Natchpai/AeroOptix-Horizon/assets/AO-Horizon-title-v2.png

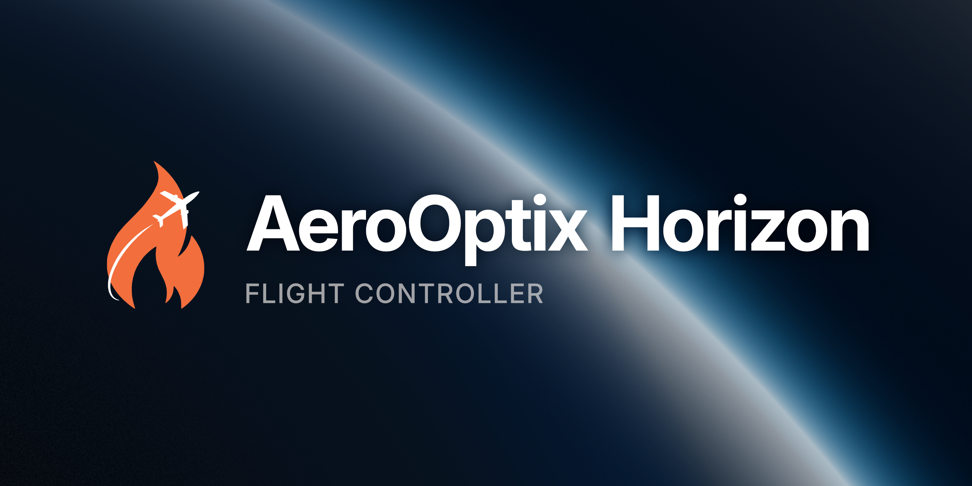
assets/AO-Horizon-title-v2.png
