Natchpai/AeroOptix-Horizon/hardware/AO-Horizon/documents/design/README.md

# Design Documents

The specification is the requirements source of truth. The other records point to its IDs instead of repeating them.

| File | Content |
| ---- | --- |
| `AO-HORIZON_SPEC_EN.md` | Hardware requirements, decisions (DEC-xxx) and open items (OPEN-xxx). |
| `AO-HORIZON_EXECUTION_CHECKLIST_EN.md` | P0 to P4 work plan and evidence tracker. |
| `AO-HORIZON_IMU_SELECTION_EN.md` | ICM-45686 selection, key data and sourcing (DEC-008, DEC-009). |
| `AO-HORIZON_BARO_MAG_SELECTION_EN.md` | ICP-20100, BMP581 (BMP384 fallback) and IST8310 selection (BMM150 replaced, BMP390 removed): key data and sourcing (DEC-010, DEC-011, OPEN-019). |
| `AO-HORIZON_POWER_BUDGET_EN.md` | Draft rail loads, tolerances, brownout and protection needs (P0-017). |
| `AO-HORIZON_PIN_ALLOCATION_EN.md` | Draft STM32H743 and STM32F100 pin allocation (P1). |
| `AO-HORIZON_H7_MCU_SOURCING_EN.md` | STM32H743VI price and stock snapshot. |
| `AO-HORIZON_PINMAP_REVIEW_EN.md` | H743 and IO MCU pinmap review 0.3, answered by the software team on 2026-10-24 (0.2 answers kept). Applied in spec rev 0.12, with the IO MCU changed to the F100. Not approved. |
| `AO-HORIZON_PINMAP_DECISIONS_EN.md` | Spec changes, team decisions and software answers after pinmap review 0.2. Answered 2026-10-24; applied in spec rev 0.11, S7 update in 0.12. |
| `AO-HORIZON_INTEGRATION_QUESTIONS_EN.md` | Integration questions rev 0.4: open questions only (P0-022): ESC (D13), parts and team tests. Earlier answers are in spec rev 0.13 and 0.14 and in Git history. |
| `AO-HORIZON_POWER_MUX_NOTES_EN.md` | TPS2121 power mux: the four modes and how to calculate the PR1, CP2, OV, ILIM and SS parts, with the values as drawn (DEC-029 to DEC-034). Design note, not a record. |
| `what-next.md` | Personal reminder list of next steps. Points to spec and checklist IDs; not a record. |
