Natchpai/AeroOptix-Horizon/hardware/AO-Horizon/documents/design/AO-HORIZON_POWER_BUDGET_EN.md

# AeroOptix-Horizon: Power Budget

**Revision:** 0.15
**Updated:** 2026-11-03
**Status:** Draft record with open `TBD` rows. The main 3.3 V buck is TPS62142RGTR (DEC-012), the 5 V input is a TPS2121 power mux with a 1.5 A limit (DEC-029, DEC-030) and the `+3V3A` LDO is TPS73533DRBR (DEC-027). No other rail, regulator or protection part is approved. Not a verification record.
**Requirement refs:** PWR-010 to PWR-014, SAF-012 to SAF-014, OPEN-006, OPEN-007, OPEN-011, OPEN-012 (closed), OPEN-021, OPEN-024 (closed), OPEN-025 (spec rev 0.24). Decisions: DEC-010, DEC-012, DEC-016, DEC-018, DEC-019, DEC-025, DEC-026 (superseded), DEC-027, DEC-028, DEC-029, DEC-030, DEC-031, DEC-032, DEC-033, DEC-034. Checklist task: P0-017.
**Decision owner:** Hardware

Single record for rail loads, rail tolerances, brownout thresholds and power protection requirements.

Evidence labels follow `.claude/rules/engineering.md`: `VERIFIED`, `ASSUMED`, `ESTIMATED`, `NOT_VERIFIED`. No datasheet PDF was opened by Claude; TI values come from NotebookLM source fulltext.

Source keys used below:
- **Spec**: `AO-HORIZON_SPEC_EN.md`.
- **Bosch**: Bosch Sensortec product page, fetched 2026-10-18.
- **IMU rec**: `AO-HORIZON_IMU_SELECTION_EN.md` (datasheet values extracted by agy, `NOT_VERIFIED`).
- **Snippet**: search-result text of a PDF datasheet. Not opened, always `NOT_VERIFIED`.
- **TI**: ti.com product pages and HTML datasheets (TPS62142: SLVSAJ0F Rev. F; TPS735: SBVS087M), fetched 2026-10-18 and 2026-10-19.
- **TI eFuse**: TPS2592x datasheet SLVSCQ3B (June 2016), NotebookLM notebook `TPS25925x eFuse` (added by the human owner, 2026-10-31), read as source fulltext. The eFuse was removed on 2026-11-01 (DEC-029).
- **TI mux**: TPS212x datasheet SLVSEA3F (August 2020), NotebookLM notebook `TPS212x 2.8-V to 22-V Priority Power MUX with Seamless Switchover` (added by the human owner), read as source fulltext.

Fetches to st.com, invensense.tdk.com, te.com and en.benewake.com failed on 2026-10-18 (`getaddrinfo EAI_AGAIN`). The rows that depend on them are `TBD`.

## 1. Fixed limits

| Item | Value | Source | Label |
| ---- | ----- | --- | ----- |
| Board input (PWR-010) | 4.5 / 5 / 5.5 V min/nom/max, ±10 %, source capacity 2 A | Spec, DEC-007 | `VERIFIED` (requirement) |
| Servo supply (PWR-011) | 6 V nominal, min/max TBD; 10 A continuous, 15 A instantaneous (UBEC-10A reference, not an approved part). On the board: the UBEC (10 A, XT30, model TBD) plugs into a board-mount XT30 and the 8 headers share a 6 V bus (DEC-019) | Spec, DEC-007, DEC-019 | `VERIFIED` (requirement) |

## 2. Candidate power tree

From the spec diagram. Candidate only, not approved (spec PWR-013).

```text
6S battery -> XT90-S -> PM02D -> CRIUS PDB v1.0
                           |            |
                           |            +-> 6 V UBEC -> board XT30 -> on-board 6 V bus
                           |                             -> 8 servo headers (+ IF-050 sense)
                           +-> TPS2121 mux IN1, 1.5 A (DEC-029/030) -> 5 V bus -> 3.3 V (MCUs, baro, mag)
                                                                  +-> +3V3A LDO -> 3.3 V_IMU (2 × IMU only, DEC-025)
                                                                  +-> 5 V external connectors
USB VBUS (bench) -> TPS2121 mux IN2 ----------------------------^
```

- `ASSUMED`: the 5 V input feeds the external connectors directly, and both 3.3 V rails come from the 5 V input.
- 3.3 V_IMU is the `+3V3A` rail from its own LDO, and it feeds only the 2 IMUs, on VDD and VDDIO (DEC-025, human owner, 2026-10-26). The LDO is TPS73533DRBR (DEC-027, 2026-10-31).
- USB VBUS powers the board and all external 5 V ports on the bench without the battery (team; all ports: human owner, 2026-10-24). Since 2026-11-01 the TPS2121 power mux joins USB (IN2) and the PM02D (IN1) and blocks reverse current on both channels (TI mux 9.3.6, `VERIFIED`). PR1 has a 12.1 kΩ / 5 kΩ divider from the PM02D and CP2 a 16.5 kΩ / 5 kΩ divider from `VBUS` (DEC-031 to DEC-034), so the PM02D has priority; USB takes over below about 3.98 V typ at `VBUS` 5.0 V (XCOMP) or 3.56 V typ (VREF mode, 16.5 kΩ not fitted).
- The saved `power_supplies.kicad_sch` draws `+3V3` from the TPS62142RGTR buck (DEC-012) and `+3V3A` from the TPS73533DRBR LDO (DEC-027), both fed from `+5V`; the buck through a 0.33 µH inductor (`+5V_BUCK`). The TPS2121 power mux (U101) is wired from `PM02_5V` (IN1) and `VBUS` (IN2) to `+5V`, with ILIM 80.6 kΩ, a PR1 priority divider 12.1 kΩ / 5 kΩ, a CP2 divider 16.5 kΩ (fitted) / 5 kΩ from `VBUS`, OV dividers 23.7 kΩ / 5 kΩ on both inputs and SS 10 nF; checked against TI mux on 2026-11-01 (sections 6 and 7). The human owner declared the sheet complete on 2026-10-31 and changed the 5 V input to the power mux on 2026-11-01. Since 2026-11-03 a status LED on the mux ST pin is drawn again: Q101 switches D103 from `+5V` (OPEN-025, drawn, not decided; its current is `TBD` until the resistor values are set). Details: spec 4.3 "Schematic state".

## 3. Load table

Typical or average current per load. Peak current listed where known. "TBD" means no source yet.

### 3.3 V_IMU

| Load | Qty | Current each | Peak | Source | Label |
| ---- | --- | --- | ---- | --- | ----- |
| ICM-45686, 6-axis low-noise, 6400 Hz | 2 | 0.44 mA | TBD | IMU rec (DS Table 3) | `NOT_VERIFIED` |

### 3.3 V

| Load | Qty | Current each | Peak | Source | Label |
| ---- | --- | --- | ---- | --- | ----- |
| STM32H743VIT6 | 1 | TBD | TBD | Not read yet (NotebookLM notebook `STM32H743VI`) | `NOT_VERIFIED` |
| STM32F100C8T6B | 1 | 15.4 mA max at 24 MHz, all peripherals on, code from Flash, TA 85 °C | Not stated | F1 value-line DS Table 12 (NotebookLM) | `VERIFIED` for the table condition (8 MHz external clock with PLL); at a 24 MHz HSE without PLL `ESTIMATED` as no higher |
| ICP-20100 | 1 | TBD | TBD | invensense.tdk.com unreachable | `NOT_VERIFIED` |
| BMP581 (barometer 2, DEC-010) | 1 | TBD | TBD | Not read yet (NotebookLM notebook `BMP581`) | `NOT_VERIFIED` |
| IST8310 (magnetometer, DEC-011) | 1 | 1.2 mA at 200 sps, 0.32 mA at 50 sps (typ, AVDD 2.8 V) | Not stated | IST8310 DS V1.2, 4.3 (NotebookLM) | `VERIFIED` at 2.8 V; at 3.3 V `NOT_VERIFIED` |
| I2C pull-ups | TBD | TBD | - | Depends on P1-004, P1-005 | `TBD` |
| LEDs: 3 board (IF-047), 3 px4io, safety LED (IF-049) | 7 | TBD (set by the resistors) | - | Resistors not chosen | `TBD` |
| External 3.3 V devices | TBD | TBD | TBD | Not defined | `TBD` |

### 5 V (external connectors and regulator input)

| Load | Ref | Current each | Peak | Source | Label |
| ---- | --- | --- | ---- | --- | ----- |
| Telemetry 1, ELRS receiver | IF-010 | TBD (5 V supply; model TBD, team) | TBD | Team | `TBD` |
| Telemetry 2 | IF-011 | TBD (no device planned; connector fitted for a second receiver) | TBD | Team | `TBD` |
| GPS1 + compass | IF-012 | TBD (Holybro M9N, to be confirmed) | TBD | Team | `TBD` |
| MS4525DO | IF-014 | TBD (5 V Pixhawk layout if the module has a regulator; 3.3 V or 5 V version TBD, team) | TBD | Snippet | `NOT_VERIFIED` |
| TF-Luna | IF-015 | 70 mA or less average (3.7 to 5.2 V supply) | 150 mA | Snippet (third-party PDF) | `NOT_VERIFIED` |
| 3.3 V regulator input | - | Sum of section 3.3 V loads | TBD | - | `TBD` |

### 6 V servo rail (on the board, DEC-019)

All of this current passes through the XT30 input and the on-board 6 V and servo GND bus (OPEN-021). Every servo model is rated for 6 V (human owner). Each servo header pin carries only its own servo's current.

| Load | Ref | Qty | Current each | Stall / peak | Label |
| ---- | --- | --- | --- | --- | ----- |
| Tilt servos, RDS3235 (team design) | IF-034 to IF-037 | 4 | TBD; team bench target: all 4 at or below 10 A while tilting 0 to 90° at hover thrust | TBD (team bench test) | `TBD` |
| Flaperon and ruddervator servos, Kingmax C507 and DS-843MG (positions TBD, team) | IF-030 to IF-033 | 4 | TBD | TBD (team bench test) | `TBD` |
| Spare outputs on the H743 | IF-017 to IF-019 | 0 planned (DEC-018); pads only | - | - | - |

All 8 servos can move at the same time (team): the tilt servos move all the time in hover, and the 4 surface servos move together in cruise.

The 4 motor outputs (IF-040 to IF-043) carry only the signal to 4 separate Skywalker 80A V2 ESCs; motor power does not pass through the board (`ASSUMED`). The ESC headers have the + pin removed, so the ESC BECs (5 V) do not reach the board.

## 4. Totals

| Rail | Known subtotal | Missing | Budget | Margin | Label |
| ---- | --- | --- | --- | --- | ----- |
| 3.3 V_IMU | 0.88 mA (2 × 0.44 mA) | IMU peak | TBD. 500 mA, TPS73533DRBR (DEC-027, TI SBVS087M 5.3). | TBD | `ESTIMATED` from `NOT_VERIFIED` inputs |
| 3.3 V | about 17 mA (IST8310 at 200 sps, F100 max 15.4 mA) | H743, ICP-20100, BMP581, pull-ups, LEDs | 2 A, TPS62142RGTR (DEC-012, TI SLVSAJ0F) | TBD | `ESTIMATED` from partial inputs |
| 5 V | 70 mA average, 150 mA peak (TF-Luna only) | All other external loads, 3.3 V regulator input | 2 A source (PWR-010); power mux limit 1.0 / 1.5 / 2.0 A with 80.6 kΩ (DEC-030, TI mux, `VERIFIED`) | TBD | `ESTIMATED` from partial inputs |
| 6 V (on the board) | none | All servo loads | 10 A cont., 15 A inst. (PWR-011), UBEC and XT30 input | TBD | `TBD` |

The subtotals are far from complete. Do not use them to size a regulator. The MCUs and the external 5 V devices are likely the largest loads (`ASSUMED`).

## 5. Rail tolerances (PWR-013)

| Rail | Nominal | Min | Max | Load step | Ripple / noise | Label |
| ---- | --- | --- | --- | --- | --- | ----- |
| 5 V input | 5 V | 4.5 V | 5.5 V | TBD | TBD | `VERIFIED` (PWR-010) for min/max |
| 3.3 V | 3.3 V | TBD | TBD, at most 3.6 V | TBD | TBD | `TBD` |
| 3.3 V_IMU | 3.3 V | TBD | TBD, at most 3.6 V | TBD | TBD | `TBD` |
| 6 V servo | 6 V | TBD | TBD | TBD | TBD | `TBD` |

Known upper bounds for the 3.3 V rails:
- ICM-45686 VDD and VDDIO max 3.6 V recommended, 4 V absolute maximum (IMU rec, `NOT_VERIFIED`).
- IST8310 AVDD and DVDD max 3.6 V recommended and 3.6 V absolute maximum (IST8310 DS V1.2, 4.1 and 4.2, `VERIFIED` via NotebookLM). This is the tightest limit on the 3.3 V rail.
- `ESTIMATED`: 3.3 V nominal leaves 0.3 V (9 %) to the 3.6 V limit for regulator tolerance, load transients and overshoot.
- F100 VDD 2 to 3.6 V (F1 value-line DS Table 8, `VERIFIED`). H743 VDD range `TBD`.

## 6. Brownout and reset thresholds (PWR-014)

| Item | Threshold | Source | Label |
| ---- | --- | --- | ----- |
| H743 BOR level (option bytes) | TBD | ST datasheet / RM | `NOT_VERIFIED` |
| H743 PVD level | TBD | ST datasheet / RM | `NOT_VERIFIED` |
| F100 POR/PDR | Falling 1.8 / 1.88 / 1.96 V, rising 1.84 / 1.92 / 2.0 V (min / typ / max), 40 mV hysteresis | F1 value-line DS Table 10 (NotebookLM) | `VERIFIED` |
| F100 PVD level | 8 levels, falling-edge typ 2.08 to 2.78 V, 100 mV hysteresis; enabled by software | F1 value-line DS Table 10 (NotebookLM) | `VERIFIED` |
| 5 V input undervoltage detect | TBD (does the board monitor 5 V?) | Not defined | `TBD` |
| 5 V power mux input UV (U101) | Rising 2.5 / 2.65 / 2.8 V, falling 2.4 / 2.55 / 2.7 V. The 4.3 V eFuse UVLO is gone with the eFuse (DEC-029) | TI mux, Electrical Characteristics | `VERIFIED` |
| 5 V source priority (U101 PR1, CP2; DEC-031 to DEC-034) | XCOMP (R105 fitted, as saved, DEC-033): to USB at 3.78 / 3.98 / 4.18 V for `VBUS` 4.75 / 5.0 / 5.25 V; worst case 4.44 V at `VBUS` 5.25 V with 1 % resistors and the 40 mV comparator offset, below the 4.5 V minimum (DEC-034). VREF mode (R105 removed): to USB at 3.39 / 3.56 / 3.73 V, back at 3.45 / 3.63 / 3.76 V. PR1 12.1 kΩ / 5 kΩ, CP2 16.5 kΩ / 5 kΩ | TI mux equations 5 and 12 form, VREF (spec 4.7) | `ESTIMATED` |
| 5 V input overvoltage (U101 OV1, OV2) | 6.08 V typ, 5.80 to 6.31 V over the VREF range before resistor tolerance; the channel turns off | TI mux 10.2.4.2, equation 6 (spec 4.7) | `VERIFIED` (typ), `ESTIMATED` (range) |
| 3.3 V buck soft-start (U102) | 10 nF SS/TR (DEC-028): about 5 ms | TI SLVSAJ0F equation 10 (spec 4.7) | `ESTIMATED` |
| 3.3 V buck PG (U102) | Open drain, pulled up by R110 100 kΩ to `+3V3`, local label `3V3_PG`, hierarchical label `3V3_DONE` (sheet pin on `top_hierarchical`, not wired further) | Saved schematic, 2026-11-01 | `VERIFIED` (as drawn) |
| 6 V servo rail monitor | Read by the F100 through the 3:1 divider (IF-050); threshold TBD | px4io-v2 | `TBD` |

## 7. Protection requirements (OPEN-006, OPEN-007, SAF-012 to SAF-014)

All `TBD`. Items to decide:

- [x] 5 V power mux values (P2-020, checked 2026-11-01), TI mux, `VERIFIED` unless marked: TPS2121, 80.6 kΩ ILIM gives 1.0 / 1.5 / 2.0 A (DEC-030); OV trip 6.08 V typ on both inputs; IN and OUT 24 V absolute maximum; input UV 2.65 V typ; 10 nF SS gives about 0.65 ms ramp and about 0.47 A inrush into about 60 µF (`ESTIMATED`, outside TI Table 9-1); fast-trip at about 2.4 × ILM, then off for about 25 ms; thermal shutdown auto-recovers. PM02D priority with a 12.1 kΩ / 5 kΩ PR1 divider (DEC-031, DEC-034) and the XCOMP fast switchover with a 16.5 kΩ / 5 kΩ CP2 divider from `VBUS` (DEC-032), R105 fitted (DEC-033).
- [x] Removed 2026-11-01 (DEC-029). 5 V input eFuse values (P2-017, closed 2026-10-31), TI eFuse, `VERIFIED` unless marked: TPS259251DRC, 45.3 kΩ ILIM gives 1.75 / 2.1 / 2.45 A; overvoltage clamp 6.1 V typ (5.5 to 6.75 V); VIN 20 V absolute maximum; turn-on at the internal UVLO (4.3 V typ); 1 nF dV/dT gives about 5 ms ramp and about 56 mA inrush into about 60 µF (`ESTIMATED`); thermal fault auto-retry after 110 ms.
- [ ] 5 V input, still open: reverse polarity; D101 SZSMF5.0A TVS rating against the PM02D input (datasheet not checked); input capacitance for the PM02D cable (TI mux section 11 suggests a large capacitance near the input for long cables; IN1 has 2 × 100 nF).
- [x] USB VBUS and PM02D 5 V OR-ing: TPS2121 power mux (DEC-029), reverse current blocking on both channels (TI mux 9.3.6, `VERIFIED`). Source priority: PM02D first, XCOMP switchover (DEC-031 to DEC-034).
- [ ] 6 V servo bus on the board (DEC-019): board-mount XT30 input, rating against 10 A continuous and 15 A peak `NOT_VERIFIED`; 6 V and servo GND copper; servo GND joined to logic GND at one point away from the sensors; no back-feed from the 6 V bus into the 5 V side (OPEN-021).
- [ ] 6 V servo rail: overcurrent behavior, pulse duration of the 15 A rating, bulk capacitance.
- [ ] USB-only power: VBUS current limit. USB feeds all external 5 V ports (human owner, 2026-10-24) (OPEN-006).
- [ ] External 5 V connectors: short-circuit protection per connector or per group.
- [ ] ESD on external connectors and USB (SAF-014).
- [ ] Safe output state on 5 V loss or 6 V fault (SAF-012, SAF-013).

## 8. Findings

| Severity | Ref | Label | Finding | Source |
| --- | --- | ----- | --- | --- |
| MAJOR | PWR-012 | `NOT_VERIFIED` | Board current budget cannot be closed: MCU currents and all external 5 V device models are missing. | Section 4 |
| MAJOR | IF-030 to IF-037 / UBEC | `NOT_VERIFIED` | All 8 servos can move at once and stall current is not known. The 10 A team target covers only the 4 tilt servos (OPEN-007). | Section 3 |
| MAJOR | XT30 input / 6 V bus | `NOT_VERIFIED` | The XT30 input carries the total servo current, up to 10 A continuous and 15 A peak. Its rating is not checked. A header position (about 3 A per pin, `ESTIMATED`) was replaced by the XT30 on 2026-10-24 (OPEN-021). | DEC-019, PWR-011 |
| INFO | U101 PR1 / `+5V` | `ESTIMATED` | Closed 2026-11-01: the drawn VCOMP mode let USB carry the board when both sources were present. PR1 now has a divider from IN1 (DEC-031, 12.1 kΩ / 5 kΩ since DEC-034), so the PM02D has priority down to about 3.98 V typ in XCOMP or 3.56 V typ in the VREF mode. | TI mux Table 9-3; spec 4.7 |
| MINOR | DEC-030 / 5 V | `VERIFIED` | The power mux limit with 80.6 kΩ is 1.0 to 2.0 A (1.5 A typ). The board plus all external 5 V loads must fit under 1.0 A for a worst-case part, with the load currents still unknown. | Section 4; TI mux |
| MINOR | U101 / `+5V` | `ESTIMATED` | With CP2 at `GND` there is no fast switchover: up to 100 µs, so `+5V` may dip about 1.7 V at 1 A into about 60 µF when the active source drops with the other present. | Spec 4.7; TI mux 9.3.7 |
| MINOR | IST8310 / 3.3 V | `VERIFIED` | IST8310 absolute maximum supply is 3.6 V, so the 3.3 V rail must never overshoot by more than 0.3 V (9 %), including start-up and load steps. | IST8310 DS V1.2, 4.1 |
| INFO | IF-022 / 5 V | `VERIFIED` (team answer) | USB VBUS powers the board on the bench. It joins the PM02D 5 V through the power mux IN2 (DEC-029). | Section 2 |
| MINOR | IF-022 / 5 V | `ESTIMATED` | USB feeds all external 5 V ports (human owner). GPS, ELRS, TF-Luna (150 mA peak alone) and airspeed together with the board may exceed a 500 mA USB port. | Section 3 |

## 9. Open inputs

- [ ] ELRS receiver model and supply current (team, P0-022). GPS: Holybro M9N supply current. Telemetry 2: no device planned.
- [ ] Servo stall current (team bench test, P0-022). Servo power passes through the board (DEC-019), so it also sizes the board input and bus.
- [x] 3.3 V_IMU rail structure: `+3V3A` from its own LDO, IMUs only (DEC-025, 2026-10-26). LDO TPS73533DRBR (DEC-027, 2026-10-31).
- [x] USB VBUS as a board power source: yes, on the bench (team). It feeds all external 5 V ports (human owner, 2026-10-24).
- [x] TPS259251DRC values from TI: done 2026-10-31 (section 7, notebook `TPS25925x eFuse`). Part removed 2026-11-01.
- [x] TPS2121 values from TI: done 2026-11-01 (section 7, TI mux).
- [x] Power mux priority: PM02D first, PR1 divider, drawn (DEC-031, 2026-11-01).
- [x] Fast switchover: XCOMP with a 16.5 kΩ / 5 kΩ CP2 divider from `VBUS`, PR1 12.4 kΩ / 5 kΩ, drawn (DEC-032, 2026-11-01); R101 later 12.1 kΩ (DEC-034).
- [x] R105 default population: fitted, XCOMP is the default (DEC-033, 2026-11-01).
- [x] XCOMP switch-point tolerance: R101 12.1 kΩ gives 4.44 V worst case with 1 % resistors, below the 4.5 V minimum (DEC-034, 2026-11-02; OPEN-024 closed).
- [ ] XT30 current rating (OPEN-021).
- [ ] STM32H743 VDD range, run current at the planned clock, BOR/PVD levels (user-supplied values or approved datasheet route). STM32F100: done (VDD 2 to 3.6 V, Table 8; sections 3.3 V and 6).
- [ ] ICP-20100 supply range and current.
- [ ] MS4525DO version (3.3 V or 5 V) and supply current (team, P0-022). The team accepts the 5 V Pixhawk layout if the module has its own regulator.
- [ ] Retry the official pages for TF-Luna and MS4525DO.

## 10. Sources

- IST8310 Datasheet, Version 1.2 (NotebookLM notebook `IST8301`, not opened by Claude)
- F1 value-line DS: ST DocID16455 Rev 9 (STM32F100x4/6/8/B), NotebookLM notebook `STM32F100`, read as source fulltext
- TF-Luna snippet source (third-party PDF, not opened): https://files.waveshare.com/upload/c/c3/SJ-GU-TF-Luna_A05_Datasheet.pdf
- TI TPS62142: https://www.ti.com/product/TPS62142
- TI TPS735 (TPS73533DRBR): https://www.ti.com/product/TPS735 and https://www.ti.com/document-viewer/TPS735/datasheet/electrical-characteristics-slvscd4719
- TI TPS212x (TPS2121): SLVSEA3F, https://www.ti.com/product/TPS2121 (ACTIVE, fetched 2026-11-01), in NotebookLM notebook `TPS212x 2.8-V to 22-V Priority Power MUX with Seamless Switchover` (added by the human owner; not opened by Claude)
- TI TPS2592x (TPS259251DRC, removed): SLVSCQ3B, https://www.ti.com/lit/ds/symlink/tps25925.pdf, in NotebookLM notebook `TPS25925x eFuse` (added by the human owner, 2026-10-31; not opened by Claude)
- ICM-45686: see `AO-HORIZON_IMU_SELECTION_EN.md`
- Requirements: `AO-HORIZON_SPEC_EN.md` sections on power, safety and interfaces
