Natchpai/AeroOptix-Horizon/hardware/AO-Horizon/documents/manufacturing/README.md

# Manufacturing Documents

This directory groups manufacturing-related documents and outputs.

- `Assembly/` — Assembly information and bill of materials.
- `Fabrication/` — Fabrication outputs such as Gerber files.
