Natchpai/AeroOptix-Horizon/hardware/AO-Horizon/documents/manufacturing/Assembly/README.md

# Assembly Documents

This directory contains assembly documentation for the project.

- `BOM/` — Bill of materials and related assembly records.
