Natchpai/AeroOptix-Horizon/hardware/AO-Horizon/documents/manufacturing/Fabrication/README.md

# Fabrication Documents

This directory contains fabrication outputs for PCB manufacturing.

- `Gerbers/` — Gerber and related fabrication files.
