Natchpai/AeroOptix-Horizon/CHANGELOG.md

# Changelog

Notable changes to this hardware project are documented here.

## [Unreleased]

### Added

- KiCad 10 project scaffold under `hardware/AO-Horizon/`: root schematic, `top_hierarchical`, `block_diagram`, `power_supplies` and `revision_history` sheets, and an empty PCB file. No schematic symbols or PCB footprints are placed yet.
- Draft advanced specification, handoff and execution checklist (`documents/design/`), rev 0.1, marked "NOT FOR FABRICATION". Defines the STM32H743VIT6 + STM32F103C8T6 dual-MCU architecture and lists open items OPEN-001 to OPEN-010.
- Custom KiCad worksheet templates, theme, and fabrication, assembly and impedance note templates (`templates/`).
- STEP 3D model for LQFP-100 14×14 mm, 0.5 mm pitch (`library/3D/`).
- Documentation folder structure with README stubs for manufacturing, schematic, verification and images.
- Project README, CERN-OHL-W-2.0 licence, and a pull request template.
- Claude Code project configuration (rules, skills, KiCad file-protection hook, permissions).
- `.gitattributes` marking development-only files (`.claude/`, `CLAUDE.md`, `README.md`, `.github/`, `.gitignore`, `.gitattributes`, `.vscode/`) as `export-ignore`.
- `CLAUDE.md` with repository layout, read-only design rules and git approval rules.
- `CHANGELOG.md`.
- Design records in `documents/design/`: IMU selection (ICM-45686), barometer and magnetometer selection (ICP-20100, BMP390, BMM150), draft power budget, draft STM32H743 and STM32F103 pin allocation, and STM32H743VI price and stock.
- Power sheet parts in `power_supplies.kicad_sch`: JST GH power module connector (`+VIN`, `PM02_SCL`, `PM02_SDA`), TPS62142RGTR 3.3 V buck with 2.2 µH inductor, TPS73533DRBR `+3V3A` LDO (drawn, not decided), 3.3 V indicator LED, and a DNP DF2S6.2CT on `+VIN`. All parts are unannotated, and `+5V` has no source yet (OPEN-012).
- Project library under `library/` with `sym-lib-table` and `fp-lib-table`: STM32 MCU, regulator, ESD, diode, connector, FET and passive parts with footprints and 3D models.
- Library starting points for the sensors: ICM-45686, ICP-20100, BMP390 and BMM150 symbols with LGA and WLCSP footprints. Not placed. Pin maps match the datasheet tables; land patterns and pin 1 orientation are not checked yet (OPEN-013). The BMM150 3D model is missing from the KiCad 10 install.
- BMP581 library starting point: `0_Sensor_Pressure:BMP581`, pin map checked against BST-BMP581-DS004-13 Rev 1.13 Table 28 through NotebookLM. Not placed. BMP581 is a candidate, not a decided part (OPEN-014).
- TPS16412DRC eFuse symbol and `Texas_VSON-10-1EP_3x3mm_P0.5mm_EP1.65x2.4mm_ThermalVias` footprint in the project library.
- TPS16412DRC eFuse placed on `power_supplies.kicad_sch` (unannotated). ERC not run.
- IST8310 library part: stock KiCad `0_Sensor_Magnetic:IST8310` symbol and `0_Package_LGA:LGA-16_3x3mm_P0.5mm` footprint, with MFR, MPN and LCSC C2683055 fields. Not placed. The IST8310 datasheet (V1.2 and V1.8) has no land pattern, so the footprint fit is `ESTIMATED` from the package drawing.
- Pinmap review sheet for the software team (`AO-HORIZON_PINMAP_REVIEW_EN.md`). Rev 0.2 adds proposed pins for the remaining functions and questions Q11 to Q19. No answers received yet.
- Pin allocation rev 0.3: draft pins for LEDs, buzzer, safety switch, IST8310 DRDY and RSTN, IMU pin 9 and F103 NRST/BOOT0 control (`ASSUMED`, not approved), and findings F-08 to F-10 (PA10 note, PM02D I2C bus not assigned, TIM15 DMA).
- PX4 Matek H743-Slim board port files as a pin-map reference in `documents/reference/px4-matek-h743-slim/`: unmodified copies from PX4-Autopilot `b26146e` and PX4/NuttX `8626377`. Not design data.
- `documents/design/what-next.md`: personal reminder list of next steps.
- Pinmap decisions file for the team (`AO-HORIZON_PINMAP_DECISIONS_EN.md`): spec rows that the team's pinmap answers change, decisions D1 to D7, software questions S1 to S7 and proposals H1 and H2, checked against PX4 v1.16.2 board files.
- Integration questions for the team (`AO-HORIZON_INTEGRATION_QUESTIONS_EN.md`, rev 0.1): servo power path (D8), mounting and cable entry (D9), environment (D10), safety switch and GPS module (D11), external devices and connectors, and software questions S8 to S10. The proposed Pixhawk-style JST-GH pinouts are `NOT_VERIFIED`. Tracked as P0-021 and spec REF-09.
- Team website in `web/` (Vite, React, shadcn-admin template): block diagram (system and board views), MCU pinouts, and an Overview with phase, gate progress, open items and recent spec changes. It reads the spec, checklist, pin allocation and root README at build time and adds no values of its own. Deployed to GitHub Pages by `.github/workflows/pages.yml` on merges to `main` (PRs #18 to #24).
- Power view on the team website: power from source to load, left to right, with grouped loads. Feeds the records do not give are drawn as candidates. Built from the spec IDs, like the other views; no new design values.
- DEC-025 (specification rev 0.16, human owner): `+3V3A` feeds only the 2 ICM-45686 IMUs, on VDD and VDDIO. OPEN-011 now covers the LDO part, the load, and the IMU SPI level match with the H743 on `+3V3` and power-up order. Checklist rev 0.15, power budget rev 0.8, IMU selection rev 0.9, root `README.md` and `what-next.md` updated to match. No KiCad file read or changed.
- README title image (`assets/AO-Horizon-v2.png`) and the AeroOptix black-and-white logo (`documents/images/Logos/`); the two old nP logo files were replaced by `np_black.png`.
- Library parts (`82f5669`): TPS25923x to TPS25926x eFuse symbols for the VSON-10 DRC package, the JIERR PCR0420 inductor footprint and 3D model, and the STM32F100C8Tx symbol (renamed from STM32F103C8Tx). Uncommitted: the TPS25925x and TPS25926x symbols now go in the BOM and on the board, and a new `L_0603_1608Metric` inductor footprint.
- DEC-026 (specification rev 0.18, human owner): TPS259251DRC eFuse between the PM02D `+VIN` and `+5V`, current-limit target 2 A. Replaces the TPS16412DRC and 1.5 A of DEC-024.
- DEC-027 (specification rev 0.19, human owner): TPS73533DRBR as the `+3V3A` LDO, with CMP-009. DEC-028: C111 SS/TR 10 nF for about 5 ms soft-start; its part number fields still name 3.3 nF (P2-019). Passive MFR and MFR.P/N are left for the human owner to choose later.
- TPS259251DRC data from TI SLVSCQ3B, read through NotebookLM (the human owner's notebook `TPS25925x eFuse`; Claude's duplicate `TPS2592x eFuse` holds the same revision). Recorded in spec CMP-008 and 4.7.
- Root sheet `AO-Horizon.kicad_sch`: a "DESIGN CONVENTIONS" text note (net names, style, reference letters, units, part fields) replaces the general-note placeholders (uncommitted).
- PCB: one 27 × 29 mm rectangle on `Edge.Cuts`, and title fields `PROJECT_ID` NP-AO-2601-V1-0 and `KICAD_VERSION` (uncommitted). Drawn, not decided; the outline stays open (OPEN-009).
- Checklist task P2-019: the power-sheet findings of 2026-10-31.
- DEC-029: a TI TPS2121 power mux replaces the TPS259251DRC eFuse (DEC-026 superseded). Power module 5 V on IN1, USB VBUS on IN2, output to `+5V`. DEC-030: power mux current limit 1.5 A. Both decided by the human owner on 2026-11-01.
- DEC-031: the PM02D (power mux IN1) gets priority through a resistor divider on PR1, replacing the drawn VCOMP mode in which USB wins. Decided by the human owner on 2026-11-01 with a 13.7 kΩ / 5 kΩ divider, changed to 12.4 kΩ / 5 kΩ with DEC-032, and drawn by the human owner the same day.
- DEC-032: the power mux uses the XCOMP fast switchover, with a CP2 divider from `VBUS`; the top CP2 resistor is a DNP option that returns it to the VREF mode. Decided by the human owner on 2026-11-01 with CP2 16.5 kΩ / 5 kΩ and PR1 12.4 kΩ / 5 kΩ, and drawn the same day (02:49 save); R105 (16.5 kΩ) is marked DNP, and the default population is open (OPEN-024).
- TPS2121 data from TI SLVSEA3F, read through NotebookLM (the human owner's notebook `TPS212x ...`). Recorded in spec CMP-008 and a new 4.7 row (power mux settings).
- Project library part for the TPS2121 (uncommitted): symbol `0_Power_Management:TPS2121RUX` in a new `0_Power_Management` family (with its `sym-lib-table` line), stock footprint copy `Texas_VQFN-HR-12_2x2.5mm_P0.5mm_ThermalVias` with the human owner's `TPS2121RUXR` STEP model, and an unused stock copy without thermal vias.
- OPEN-024 (power mux source priority), checklist task P2-020 (power mux values) and tracker row OI-026.
- DEC-033 (specification rev 0.22): R105 (CP2 16.5 kΩ) is fitted by default, so the power mux runs in the 5 µs XCOMP mode. Decided by the human owner on 2026-11-01 ("i update TPS2121RUX config in XCOMP mode about resistor div.").
- DEC-034 (specification rev 0.23): R101 is 12.1 kΩ (was 12.4 kΩ), so the worst-case power mux switch point is 4.44 V with 1 % resistors, below the 4.5 V input minimum. Decided by the human owner on 2026-11-02 ("use R101 12k1, i updated sch"). Closes OPEN-024.
- Power mux status LED drawn again on `power_supplies.kicad_sch` (uncommitted, 2026-11-03): Q101 DMG1012UW, gate on the TPS2121 ST pin (`PMUX_ST`), switches D103 LTST-C191GKT from `+5V`, so the LED is lit while the PM02D powers the board. Drawn, not decided (OPEN-025). New project symbol `0_Transistor_FET:DMG1012UW` on the stock-copy `SOT-323_SC-70` footprint; pin map against the datasheet not checked.
- PWR-015, DEC-035 and DEC-036 (specification rev 0.26, human owner, 2026-11-03): `+5V` stays below 5.5 V in normal operation, with the OV trip as a fault guard; the power mux status LED is kept; the OV top resistors R103 and R107 are 23.2 kΩ (trip 5.60 to 6.31 V with 1 % resistors, `ESTIMATED`) and ST comes from a 10 kΩ / 10 kΩ divider on `+5V`, so ST and the Q101 gate stay at 3.19 V or less. Drawn in the 14:24 save (uncommitted). P4-012 added for the ST low-level bench check.
- Q101 changed from DMG1012UW to 2SK3018W (R+O, LCSC C20069149, SOT-323) in the 14:45 save (uncommitted): VGS(th) 0.8 to 1.5 V and VGS ±20 V (human owner). New project symbol `0_Transistor_FET:2SK3018W`; pin map checked by the human owner. The DMG1012UW symbol stays in the library, unused.
- `PWR_FLAG` on `VBUS` on `power_supplies.kicad_sch` (14:51 save, uncommitted, 2026-11-03): stands in for the USB connector until it is drawn, so ERC does not flag `VBUS` as undriven. Remove it when the USB connector is added.
- DEC-037 (specification rev 0.27, human owner, 2026-11-03): two 10 µF X7R and one 47 µF 10 V MnO2 tantalum (Kyocera AVX TPSB476K010R0250, 0.25 Ω ESR, LCSC C308881) on `PM02_5V` in the 15:59 save (uncommitted), to damp cable ringing at the power mux input. The 10 V rating runs above the common 50 % derating guidance (`ASSUMED`) and was accepted by the human owner. The capacitors are not annotated yet. Hot-plug bench check added as checklist P4-013. New project footprint `0_Capacitor_SMD:CP_EIA-3528-21_Kemet-B` (stock pads and 3D model). ERC not run (`NOT_VERIFIED`).
- Specification rev 0.28 (2026-11-03): the human owner reopened the PM02D connector type, JST-GH as drawn or the 6-pin 2.00 mm CLIK-Mate chosen on 2026-10-24. IF-048, OPEN-023 and checklist P2-015 and OI-025 now say to decide before PCB placement, from the team's cable and the contact current rating (about 0.75 A per pin, `NOT_VERIFIED`). No schematic change.
- DEC-038 (specification rev 0.28, human owner, 2026-11-03): USB is a bench supply; the bench USB-C port shall supply more than 1 A, and brown-out of the external 5 V devices on a weaker port is accepted. Power budget rev 0.17: H743 Run current from ST DS12110 Rev 11 Table 120 (220 mA typ, 436 mA max at Tj 85 °C, 546 mA at Tj 105 °C, `VERIFIED`), the board 5 V load (about 190 to 495 mA) and the 5 V headroom table (`ESTIMATED`). Checklist P4-014 added.
- DEC-039 (specification rev 0.29, human owner, 2026-11-03): the `+3V3A` LDO (U103) EN comes from the buck power-good `3V3_PG` through R115 0 Ω, with C120 10 nF to `GND` (16:51 to 16:59 saves, uncommitted), so `+3V3A` starts after `+3V3` and the IMU pull-ups no longer hold the H743 SPI1 pins high while the H743 is off. Checklist P4-015 added.
- Buck check (specification rev 0.29, 4.3, 2026-11-03): TI SLVSAJ0F current limit and inductor sizing (`VERIFIED`); L102 PCR0420-3R3-M saturation current 3.5 A (human owner) covers the full 2 A rating with 20 % margin; the 3 × 10 µF output fits TI Table 9-2 and the 0.33 µH input filter is damped (`ESTIMATED`). Open: L101 is rated 1.2 A (distributor, `NOT_VERIFIED`), enough for the expected load but not the full 2 A output.
- 17:11 save of `power_supplies.kicad_sch` and `top_hierarchical.kicad_sch` (uncommitted, 2026-11-03): `PWR_FLAG` on `+5V_BUCK`, `GND` and `+3V3`; the PG hierarchical label and sheet pin renamed from `3V3_DONE` to `3V3_PG`. ERC run by the human owner: only the unconnected hierarchical sheet pins remain, set aside. The project ERC pin map now treats Output to Output and Power output to Power output as no error (`AO-Horizon.kicad_pro`). `sch-review` by Claude (spec rev 0.29, 4.3): no defect found within the sheet; L101 rating open. D101 breakdown voltage 6.4 V checked by the human owner.
- DEC-040 and DEC-041 (specification rev 0.30, human owner, 2026-11-03): `+3V3` design current about 0.6 A, so L101 (1.2 A) stays; the project-wide ERC pin map change is kept. Checklist rev 0.28: P2-019 closed by the human owner; resistor part fields moved to the new task P2-021.
- Power sheet notes (18:10 and 18:15 saves, specification rev 0.31, 2026-11-03): Note fields on L101 (330 nH, 170 mΩ) and L102 (3.3 µH, 85 mΩ); filter calculation notes updated to 170 mΩ (Q 0.8, about 20 dB margin). No part or net change.
- DEC-042 (specification rev 0.32, human owner, 2026-11-03): the PM02D board connector becomes a 6-pin 2.00 mm CLIK-Mate (not drawn yet). OPEN-006 closed with the human owner's 5 V load estimates (ELRS 100, GPS 100, MS4525DO 5, TF-Luna 150, buzzer 30 mA): about 880 mA hot worst case against the 1.0 A minimum mux limit (`ESTIMATED`). Power budget rev 0.19, checklist rev 0.29.
- CN101 changed from JST-GH SM06B-GHS-TB to Molex 5024940670 (CLIK-Mate 2.00 mm, 6 pins, right angle, SMT, LCSC C587930) in the 19:24 save of `power_supplies.kicad_sch`, per DEC-042 (specification rev 0.33). New footprint library `0_Conn_Molex` in `fp-lib-table` (stock pads) with its 3D model in `library/3D/Conn_Molex/`. Pin nets unchanged; pin order against the PM02D cable `NOT_VERIFIED`.
- Correction (specification rev 0.29): spec rev 0.27 and 0.28 described the 15:59 save, but the committed sheet (`4d55a7e`) was re-annotated: input capacitors C102 to C104, old C102 to C121 now C105 to C125, parked diodes D105 and D106. The records now use the 16:55 references. C120 is GRM1555C1H103JE01D, LCSC C22400107 (16:59 save). ERC not run (`NOT_VERIFIED`).

### Changed

- Root `README.md` rewritten from the draft specification: overview, key features, specifications, architecture, logical interface allocations, design considerations and open items. Undecided values are marked `TBD`; all verification checks are `NOT_VERIFIED`.
- `.gitignore` now ignores `settings.local.json`.
- Library folder references in `.claude/` (permission deny rule, hook message, skills, README template) changed from `Library/` to lowercase `library/` to match the actual directory.
- Licence changed from CERN-OHL-W-2.0 (weakly reciprocal) to CERN-OHL-S-2.0 (strongly reciprocal); `LICENSE` text and the README licence section updated.
- Removed the stale `meta/` entry from the repository tree in `hardware/AO-Horizon/README.md`.
- Specification rev 0.1 to 0.7: recorded decisions DEC-005 to DEC-012 (USART monitoring path, board size limit under 80 mm × 80 mm, power input and servo limits, 2 × ICM-45686 with software reset, ICP-20100 + BMP390, 1 × BMM150, TPS62142RGTR main 3.3 V buck), open items up to OPEN-013, and the power-sheet and sensor-library state. Execution checklist is at rev 0.6.
- Sensor lifecycle recorded: ICP-20100 is EOL (TDK), and Bosch no longer lists BMM150. Both are decided parts (DEC-010, DEC-011), so their sourcing stays open (OPEN-004).
- Library names follow KLC: `STM32F103C8Tx`, `0_Conn:Conn_ARM_JTAG_SWD_10`, `0_Diode:SMBJ30A`, the VSON-8 thermal-via footprint (its two schematic Footprint fields updated), and lowercase `.step` model files.
- Claude Code configuration: KiCad library checks and syncs now run from the global `kicad-*` skills, the local `hw-link-audit` and `hw-*-sync` copies are removed, the `progress-update` skill is added, and all project skills are tracked.
- BMP390 removed from the design because LCSC C5124834 is not available (DEC-010 revised, specification rev 0.8, checklist rev 0.7). The second barometer is open (OPEN-014); Bosch BMP581 (LCSC C5362283) is proposed and waits for team confirmation. The BMP390 library symbol and footprint are kept until then.
- `Bosch_LGA-10_2x2mm_P0.5mm_LayoutBorder3x2y` pads changed from the ST size (0.425 × 0.35 mm) to the BMP581 land pattern (0.325 × 0.30 mm, smallest gap 0.20 mm); description and tags updated. The pad sizes were read from a datasheet figure and are `NOT_VERIFIED`. DRC not run.
- Root `README.md`: `Status` changed from `CONCEPT` to `DRAFT` to match the declared phase.
- Root `README.md` and `CLAUDE.md` rewritten for the current design state and workflow. `hardware/AO-Horizon/README.md` and the `documents/` and `documents/design/` indexes now name the real project files and records.
- Magnetometer changed from Bosch BMM150 to iSentek IST8310 by the human owner (DEC-011 revised, specification rev 0.9, checklist rev 0.8, selection record rev 0.5, power budget rev 0.4). IST8310 values come from its datasheet V1.2 through NotebookLM. Its absolute maximum supply is 3.6 V, so the 3.3 V rail has only 0.3 V of margin. The BMM150 library files are kept and marked not used.
- Project library restyled to the KLC house style: symbols redrawn with separate pins, footprint fab, silkscreen and courtyard redrawn. Later, field and body positions moved on the IST8310, BMP390, BMP581 and TPS62142 symbols.
- `.gitignore` now ignores the `hardware/AO-Horizon/libDump/` staging folder.
- Pinmap review rev 0.2 now holds the software team's answers (2026-10-24).
- Specification rev 0.10 and checklist rev 0.9: Pixhawk 6X Rev 8 added as a reference next to Pixhawk 6C by the human owner (DEC-013, REF-05, SYS-002). Team answers recorded on OPEN-001 to OPEN-003, OPEN-008, OPEN-014 and DEC-011 without changing requirement rows. New open items OPEN-015 (stock px4io expects a 24 MHz F103 clock; DS5319 Rev 20 Table 22 limits the crystal to 4 to 16 MHz) and OPEN-016 (spec rows the team's answers change), with task P0-019. The IST8310 library row now names the stock symbol and footprint.
- Pin allocation rev 0.4 (pin source note, team changes in section 2.1, findings F-11 to F-14), barometer and magnetometer selection rev 0.6 and IMU selection rev 0.8 record the team's answers. Pin tables are unchanged until the team decides. No KiCad file changed; ERC and DRC not run.
- Root `README.md`: header field `Revision` renamed `Board revision`.
- Specification rev 0.11: the software team's answers in the pinmap decisions file (rev 0.2) are applied, and the human owner accepted them. New decisions DEC-014 to DEC-018:
  - H743 pins follow `px4/fmu-v6c` and F103 pins follow `px4/io-v2`, with PX4 v1.16.2.
  - The px4io link runs on H743 USART6 to F103 USART2 at 1.5 Mb/s.
  - The 4 motors move from the F103 to H743 TIM5 (DShot only, bidirectional). The F103 drives 8 servos (flaperons, ruddervators, 4 tilt servos).
  - SAF-001 changes from "immediate landing" to: servo failsafe after 0.5 s without H743 data, and the motors stop when their DShot frames stop.
  - Crystals: H743 16 MHz; F103 8 MHz with PLL ×3, with px4io and its bootloader rebuilt by the software team. The human owner kept the F103 over the team's STM32F100 proposal.
  - The interface set changes: GPS2, the reserved UART7 TX, I2C3 and FlySky are dropped. Added: microSD on SDMMC1, a buzzer on TIM3_CH3, 3 LEDs, a Pixhawk Debug Mini connector, and the F103 safety switch.

  BMP581 is accepted as barometer 2 (BMP384 fallback). Interface rows IF-040 to IF-051 and SAF-015 are added. OPEN-002, 003, 008, 014, 015 and 016 are closed. New open items: motor stop depends on the ESC (OPEN-017), pull-down value with bidirectional DShot (OPEN-018), BMP384 fit (OPEN-019).
- Pin allocation rev 0.5: team changes applied to both MCU tables. New pins checked against ST open pin data, and the TIM5 and TIM3 AF numbers checked against the NuttX pinmap. px4io-v2 reserved F103 pins listed. Pinmap review rev 0.3 sent to the team for the new rows and questions Q20 to Q22, with the 0.2 answers kept.
- Checklist rev 0.10, barometer and magnetometer selection rev 0.7, root `README.md` and `what-next.md` updated to match. New tasks: P0-020 (team reply to pinmap 0.3), P1-015 (BMP384 fit), P2-013 (pull-down value) and P4-011 (H743 halt bench test). No KiCad file changed. ERC and DRC not run.
- IO MCU changed from STM32F103C8T6 to STM32F100C8T6B with a 24 MHz crystal, following the software team (specification rev 0.12: DEC-002, DEC-017, MCU-002, CMP-002). Stock px4io-v2 and its stock bootloader run unchanged; the bootloader runs from HSI (PX4-Bootloader `main_f1.c`). No pin moved: ST open pin data for both LQFP48 parts match on all 48 pins. F100 values from DocID16455 Rev 9 through NotebookLM: HSE 4 to 24 MHz, VDD 2 to 3.6 V, reset and PVD levels, 5 V tolerance (OPEN-020, added and closed). LCSC stock checked by the human owner. The F100 library part and the `block_diagram` text are still to do (P2-014).
- Pinmap review rev 0.3 now holds the software team's answers and a hardware response. Applied: the three px4io LEDs are fitted, F100 PA10 and PB11 get weak pull-ups, the BMP384 fallback is at 0x76 (OPEN-019), and the debug connector pinout is accepted.
- Pin allocation rev 0.6, checklist rev 0.11 (P0-020 done; new P0-021 and P2-014), power budget rev 0.5 (F100 current, reset and PVD levels), barometer and magnetometer selection rev 0.8, the decisions file, root `README.md`, `CLAUDE.md`, the design README and `what-next.md` updated to match. No KiCad file changed. ERC and DRC not run.
- Specification rev 0.13: the software team's answers to the integration questions are applied. New decisions:
  - DEC-019: 8 × 3-pin servo headers (signal, +6 V, GND) on an on-board 6 V rail, with the UBEC plugged into the board, Pixhawk style. The human owner chose this instead of the team's answer (signal and GND only, 6 V through the harness).
  - DEC-020: parts rated −40 to +85 °C, no conformal coating, no rain exposure.
  - DEC-021: GPS1 is the 10-pin full GPS port with the safety switch lines; Model G flies with the safety switch disabled in PX4; the board buzzer stays.
  - DEC-022: stock px4io image in the board's `extras/` folder, no IMU heater.
  - DEC-023: PC1 stays reserved for an analog power module; the ESC current sense goes to another ADC pin (human owner).

  Interface rows updated, and IF-052 (ESC current sense) and IF-053 (ESC telemetry) added. Mounting stays a proposal (30.5 × 30.5 mm M3, soft mount) until the CAD team confirms it (OPEN-009). New open items: UBEC input rating and servo rail copper (OPEN-021), ESC sense and telemetry pins (OPEN-022), connector pinouts and the PM02D connector, where the power sheet's JST-GH may not match the team's CLIK-Mate cable (OPEN-023).
- Checklist rev 0.12 (P0-021 done; new P0-022, P1-016, P2-015, P2-016), power budget rev 0.6 (servo rail on the board, USB-only bench power), the design README and `what-next.md` updated to match. No KiCad file changed. ERC and DRC not run.
- Integration questions rev 0.3: the team's answers kept, a note on what hardware decided after them, and follow-up questions for the team (mounting for the CAD team, devices needed on USB, ESC current use in PX4, part models and photos, test results).
- Specification rev 0.14: the human owner answered the hardware side of the follow-up questions.
  - Mounting: M3 screws, 3.2 mm holes, soft mount, board on its own tray, USB-C and microSD on adjacent edges, part height about 10 to 15 mm. Hardware sets the outline, cable entry sides and dampers at placement; the CAD team follows (MEC-002 to MEC-004, OPEN-009).
  - USB powers the board and all external 5 V ports on the bench (IF-022, OPEN-006).
  - UBEC input on a board-mount XT30 instead of a servo header position (DEC-019, PWR-011, OPEN-021).
  - PM02D board connector to match its 6-pin 2.00 mm CLIK-Mate cable; the power sheet still draws JST-GH (IF-048, OPEN-023).
  - ESC connectors: 4 × 3-pin headers with the + pin removed (IF-040).
  - DEC-024: TPS16412DRC eFuse between the PM02D and `+5V`, current limit 1.5 A. Placed, not wired (OPEN-012).
  - Team parts recorded: 4 × Skywalker 80A V2 ESCs, 4 × RDS3235 tilt servos, Kingmax C507 and DS-843MG servos (all rated for 6 V), 10 A UBEC with XT30, MS4525DO.

  The Skywalker ESCs look PWM-only (no source found for DShot), which conflicts with FUN-002 and SAF-015. FUN-002 is unchanged; the team is asked in D13 (OPEN-017).
- Integration questions rev 0.4: cleaned to open items only (D13 on the ESC, parts table, team tests). Answered sections are in rev 0.3 in Git history.
- Checklist rev 0.13 (P0-022 rewritten; P1-016 `N/A`; new P2-017 eFuse and P2-018 ESC headers), power budget rev 0.7, design README, root `README.md` and `what-next.md` updated to match. No KiCad file read or changed. ERC and DRC not run.
- Specification rev 0.15, a consistency pass with no new decisions: CMP-008 added for the TPS16412DRC eFuse (DEC-024) and the eFuse named in OPEN-010 and the verdict. Older text now matches rev 0.14 (UBEC on a board-mount XT30 in DEC-019 and the power-input scenario, USB feeding all 5 V ports, Skywalker ESCs in the DEC-016 notes). The spec now records that its power-sheet table (17 parts, DNP DF2S6.2CT) disagrees with the README and this changelog; not re-checked.
- Checklist rev 0.14 (P0-013 XT30 wording, P0-016 adds DEC-024, next action), root `README.md` (spec rev, website link, repository tree), `what-next.md` and `web/HANDOFF.md` updated to match. The website eFuse block names CMP-008. No KiCad file read or changed. ERC and DRC not run.
- Team website: the diagram views are renamed (the outer view is now Overview, the inner view System; URL ids unchanged). The System view has no power parts any more, the Overview's power chain runs left to right, and the Power view shows the IMUs on `+3V3A`. Link ends on each block side are spaced equally and centred, checked at build time. The home page has a Power view card. On the System view, I2C2 is drawn as one bus from the H743 to the two barometers and the magnetometer, connectors sit in titled zones (Connectors; USB and debug; On-board I/O) and have a tab on the cable side, and the F100 SWD pads are left of the F100. The Overview shows the board ports: each device line starts at the port it plugs into, with one In board (PCB) zone for the FC and its ports, and out-board zones for the outside modules (power, devices, actuators).
- Power sheet (`power_supplies.kicad_sch`, saved file, uncommitted at the time of the check), now 28 parts, all unannotated. All drawn, not decided, apart from the eFuse (DEC-024) and the buck (DEC-012):
  - TPS16412DRC eFuse wired from `+VIN` to `+5V`, with an OVP divider, ILIM and IOCP/IMON resistors, IDLY and dV/dt capacitors (all values `?`) and a red fault LED on ~FLT. EN/~SHDN is not connected (OPEN-012).
  - The TPS62142RGTR buck is fed from `+5V` through a ferrite bead (`+5V_BUCK`), with 2 × 10 µF at its input.
  - TPS73533DRBR LDO: 10 µF input, 10 µF and 100 nF output. The NR capacitor is still 100 nF (OPEN-011).
  - One `PWR_FLAG` on `+VIN`.
- Specification rev 0.17 (no new decisions): the 4.3 schematic-state table rewritten from the saved sheet, OPEN-011 and OPEN-012 updated. Checklist rev 0.16 (P2-017 now `IN_PROGRESS`, P2-011, OI-013, OI-014, next action), power budget rev 0.9, root `README.md` and `what-next.md` updated to match.
- Power sheet (`power_supplies.kicad_sch`, saved file, uncommitted at the time of the check), now 29 parts, all unannotated. All drawn, not decided, apart from the eFuse (DEC-026) and the buck (DEC-012):
  - TPS259251DRC eFuse in place of the TPS16412DRC: EN/UVLO 1 MΩ to `+VIN`, ILIM 45.3 kΩ, dV/dT 1 nF, 2 × 100 nF on `+VIN` and 100 nF on `+5V`. Values not checked against TI data (OPEN-012). The TPS25924 stage committed in `0cda54e` is no longer on the sheet.
  - Buck input: 0.33 µH ASMPH-0603-R33M-T from `+5V` to `+5V_BUCK` in place of the ferrite bead, and a 100 nF AVIN capacitor. Buck inductor: 3.3 µH JIERR PCR0420-3R3-M in place of the 2.2 µH Abracon part.
  - TPS73533DRBR NR capacitor 10 nF (was 100 nF); output 2 × 10 µF and 100 nF.
  - 3.3 V LED resistor 510 Ω.
- KiCad project: migrated to project template Rev4 (`ccf29de`), `+6V` net class and LCSC column in the BOM (`55a9a50`), fonts embedded in the root sheet (`f71c0ca`).
- Specification rev 0.18: DEC-026 added and DEC-024 marked superseded; the 4.3 schematic-state table rewritten; part-number boundary, CMP-008, OPEN-010 to OPEN-012 and the verdict updated. Checklist rev 0.17 (P0-016, P2-011, P2-017, OI-004, OI-012 to OI-014, next action), power budget rev 0.10, root `README.md` and `what-next.md` updated to match.
- Power sheet (`power_supplies.kicad_sch`, saved file, uncommitted), declared complete by the human owner on 2026-10-31. Now 31 parts, annotated (U101 to U103, C101 to C120, R101 to R104, L101, L102, D101, CN101), every part with a footprint. All drawn, not decided, apart from the eFuse (DEC-026) and the buck (DEC-012):
  - TPS62142 PG pulled up by R103 100 kΩ to `+3V3`, on a `5V_PG` label and hierarchical label (no sheet pin on the parent yet).
  - SS/TR capacitor C111 value 10 nF; its MPN and LCSC still name the 3.3 nF part.
  - 10 µF count: 3 on `+5V`, 3 on `+5V_BUCK`, 3 on `+3V3`, 1 on `+3V3A` (was 2, 2, 3, 2).
  - The `+VIN` net label is gone; the input net is now `Net-(CN101-Pin_1)` in the `+5V` net class (`AO-Horizon.kicad_pro`).
- TPS62142 project symbol: PG, FB and VOS pin positions moved; pin numbers, names and types unchanged (uncommitted).
- Specification rev 0.19 (DEC-027, DEC-028): 4.3 schematic-state table rewritten; CMP-008 holds the TPS259251DRC data from TI; two 4.7 rows added (eFuse settings, buck soft-start); OPEN-012 closed, with reverse current and the 5 V budget moved to OPEN-006; OPEN-011, OPEN-023 and the verdict updated. Checklist rev 0.18 (P0-016, P2-011 and P2-017 `DONE` on the human owner's statement, P2-019 added, OI-004, OI-012, OI-013, OI-014 closed, next action), power budget rev 0.11, root `README.md` and `what-next.md` updated to match.
- Specification rev 0.20 (no new decisions): corrects rev 0.19, which was written before the human owner's last save of `power_supplies.kicad_sch`. As committed in `895c26a`, the TPS62142 PG net has local label `3V3_PG` and hierarchical label `3V3_DONE` (not `5V_PG`), and C111 is 0402 with empty MFR.P/N and LCSC (no 3.3 nF part number). Checklist rev 0.19 (P2-019, next action), power budget, root `README.md` and `what-next.md` updated to match.
- KiCad updated to 10.0.8 by the human owner; the root `README.md` header now says `10.0.8`. The saved project and PCB carry `KICAD_VERSION` "KiCad E.D.A 10.0.8"; the file format stays `generator_version` 10.0.
- Power sheet `power_supplies.kicad_sch` on 2026-11-01 (uncommitted, saved by the human owner):
  - The eFuse is replaced by the TPS2121 power mux (U101) with OV dividers on both inputs, an 80.6 kΩ current-limit resistor and a 10 nF soft-start capacitor. Later saves the same day added the PR1 divider (DEC-031, now 12.4 kΩ / 5 kΩ) and the CP2 divider from `VBUS` (DEC-032, R105 16.5 kΩ marked DNP, R106 5 kΩ), removed the ST status LED (ST to `GND`) and filled U101's MFR, MFR.P/N (TPS2121RUXR) and LCSC fields.   - New input parts: SZSMF5.0A TVS on `PM02_5V`, PESD2USB3UV-T ESD on the PM02D I2C lines, and two DNP TVS diodes that are unannotated and not connected.
  - The input net is named `PM02_5V` again; `VBUS` enters from a power symbol (USB connector on another sheet, later). Both are in the `+5V` net class.
  - References renumbered: 43 parts, C101 to C121, R101 to R111, D101, D102, D104. The SS/TR capacitor of DEC-028 is now C112, the LDO NR capacitor C119.
  - `top_hierarchical`: the power sheet symbol now has sheet pins `3V3_DONE`, `PM02_SCL` and `PM02_SDA`.
- ESD symbol library (uncommitted, edited by the human owner): 8 symbols in `0_Protection_ESD` changed and 3 added (`D_ESD_DUAL`, `D_TVS-ESD_uni`, `PESD2USB3UV-T`); `TPS73533DRB` symbol changed. Not reviewed by Claude.
- Specification rev 0.21 (DEC-029, DEC-030): part-number boundary, 4.3 power architecture and schematic-state table, CMP-008 (now the TPS2121), the 4.7 power mux row, OPEN-006 (eFuse back-feed concern gone), OPEN-010, OPEN-011 and the verdict. Checklist rev 0.20 and power budget rev 0.12 follow it.
- Power sheet `power_supplies.kicad_sch` on 2026-11-02 (uncommitted, saved by the human owner): R105 is no longer DNP; R106 and its `GND` symbol moved with no net change; the XCOMP text notes now show the CP2, PR1 and switch-point calculation for `VBUS` 4.75 / 5.0 / 5.25 V, and the OV note uses 23.7 kΩ (6.08 V rising, 5.97 V falling).
- Specification rev 0.22 (DEC-033): 4.3 schematic state, the 4.7 power mux row and OPEN-024. OPEN-024 now covers only the switch-point tolerance: with 1 % resistors and the 40 mV comparator offset, the worst case is 4.52 V at `VBUS` 5.25 V, 0.02 V above the 4.5 V input minimum (`ESTIMATED`). Checklist rev 0.21, power budget rev 0.13 and power mux notes rev 0.2 follow it.
- Power sheet `power_supplies.kicad_sch`, 00:32 save on 2026-11-02 (uncommitted, saved by the human owner): R101 value 12k4 to 12k1; the PR1 and switch-point notes now read 3.78 / 3.97 / 4.18 V. No net change.
- Specification rev 0.23 (DEC-034): 4.3 schematic state, the 4.7 power mux row (XCOMP 3.78 / 3.98 / 4.18 V, VREF mode 3.39 to 3.76 V, `ESTIMATED`), OPEN-024 closed. Checklist rev 0.22 (P2-020, OI-026 closed), power budget rev 0.14 and power mux notes rev 0.3 follow it. The root README drops OPEN-024 from the open list.
- Specification rev 0.24 (no new decisions): 4.3 schematic state from the 13:24 save on 2026-11-03 (47 parts, 45 annotated), OPEN-025 added, the 4.7 soft-start row and the verdict. Part fields added to Q101, D103, D104, C105, C112 and C119; D104 Value is now LTST-C191GKT (was LTSL-C191TGKT). The resistors were renumbered and some values changed; the human owner decides the resistor fields later, so resistor references and values in the records are not updated. Checklist rev 0.23 (P2-019, OI-027), power budget rev 0.15 and power mux notes rev 0.4 follow it. The root README lists OPEN-025.
- Specification rev 0.25 (no new decisions): Q101 DMG1012UW VGS(th) maximum about 1 V and VGS absolute maximum ±6 V, supplied by the human owner, recorded in 4.3 and OPEN-025. The 5 V gate drive is fine; the OV trip must stay below 6 V for the Q101 gate and the U101 ST pin (`ESTIMATED`). Checklist OI-027 follows it.
- Specification rev 0.26: 4.3 schematic state from the 14:24 save on 2026-11-03 (48 parts, 46 annotated), with the saved resistor references (renumbered again: R109 and R110 ST divider, R111 D103 LED, R112 ILIM, R113 PG pull-up, R114 D104 LED); D103 and D104 MFR and MFR.P/N fixed; CMP-008 adds the VREF falling values and ST leakage; the 4.7 power mux row uses the 23.2 kΩ OV dividers; OPEN-025 narrowed to the ST low level. Checklist rev 0.24 (P2-019, P2-020, OI-027, P4-012), power budget rev 0.16, power mux notes rev 0.5, README and `what-next.md` follow it.
- KiCad title blocks (uncommitted, 2026-11-03): every sheet and the PCB show revision `A` (was `1.0`); project text variables set `PROJECT_ID` `NP-AO-2601`, drawing name and date, `RELEASE_DATE` 02-Nov-2026 and a new `STATUS` variable `DRAFT` shown on the root sheet. Root sheet text and frames moved. These are drawing fields, not a phase change.
- Team website Power view (`web/src/data/topology.ts`, `places.ts`): the eFuse block is now the TPS2121 power mux (`pw-pmux`, DEC-029 to DEC-034), with USB-C feeding it on IN2 instead of the `+5V` bar directly, and the PM02D link named `PM02_5V`. The `+3V3A` LDO block is no longer drawn as a candidate: TPS73533DRBR is decided (DEC-027). `npm run build` and `npm run test:ui` pass; the live site updates after a merge to `main`.
- Claude Code configuration (`d20d019`, 2026-11-11): `sch-inspect` and `pcb-inspect` synced from the Hardware-Copilot template v3.3.1 (sch-inspect 1.1.1, pcb-inspect 1.1.1). `sch-inspect` now looks up a placed symbol by its `lib_name`, returns only the pins of the placed body style, and no longer marks `mirror y` at 90 and 270 degrees `NOT_VERIFIED`. `pcb-inspect` now reports the via type (`through`, `blind`, `buried`, `micro`) and gives one row per footprint in `net`. No KiCad file changed.

### Fixed

- Root `README.md` title image points to `assets/AO-Horizon-v2.png`; the old `AO-Horizon-title-v2.png` was renamed in `23c312d`.

- Renamed the misspelled `.cluade/` configuration folder to `.claude/` so rules, skills, hook and permissions load.
- The `Edit(**/Library/**)` deny rule did not match the lowercase `library/` directory; it now uses `library`.
- `hardware/AO-Horizon/README.md` still had template text (`my_Kicad10_Template_Rev4` file names and a `meta/` folder). It now describes the AO-Horizon project.
- The README board outline now follows MEC-001 (each dimension under 80 mm) instead of the older diagram size of about 90 mm × 95 mm.
- The power budget record (rev 0.2) no longer says that no regulator is approved; it cites DEC-012.

### Removed

- `.claude/settings.local.json` is no longer tracked (local-only file, now git-ignored).
- `AO-HORIZON_HANDOFF_EN.md`: its content was merged into the execution checklist.
- DNP DF2S6.2CT ESD diode removed from `power_supplies.kicad_sch`.
- From `power_supplies.kicad_sch` (uncommitted): the TPS16412DRC eFuse with its OVP, IOCP/IMON and IDLY parts, the red fault LED, a Zener diode and the ferrite bead.
- Unused library items: JST EH and JST ZH 2-pin footprints (`82f5669`). Uncommitted: the Panasonic OS-CON and Wuerth WCAP-ASLI capacitor footprints, the Abracon AOTA-B252010S inductor footprint, their 3D models and the JST ZH 3D model.
- ESC current sense and ESC telemetry (IF-052, IF-053) removed from the specification: the separate Skywalker ESCs have neither wire (human owner). OPEN-022 closed.
- Stale rows in the design records: GPS2 and FlySky loads and the "barometer 2 not chosen" row in the power budget, the BMP390 and BMM150 columns in the barometer sourcing table (kept as one history line), and done items in `what-next.md` and the barometer record.

### Verification

- None recorded. No ERC, DRC or design review results are confirmed. `NOT_VERIFIED`.
- Read-only checks run by Claude on 2026-10-19 against the saved files at commit b34343e: a library link audit found no broken links, and a net trace of `power_supplies.kicad_sch` matched the spec's schematic-state table. The four sensor symbols' pin maps match their datasheet pin tables, and the TPS62142 and TPS73533 circuits were compared with TI SLVSAJ0F Rev F and SBVS087M (checked through NotebookLM, text confirmed in the source fulltext). These are not ERC, DRC or a human review.
- Read-only checks run by Claude on 2026-10-24: `klc_verify` passes, the IST8310 symbol pins match the LGA-16 footprint pads, and the library link audit is clean. Not ERC, DRC or a human review.
- Read-only checks run by Claude on 2026-10-24: STM32F100C(8-B)Tx and STM32F103C(8-B)Tx compared in ST open pin data, F100 datasheet values found in the NotebookLM source fulltext, and the `progress-update` preflight found no em dashes, undefined IDs, broken links or open items without a tracker row. Not ERC, DRC or a human review.
- Read-only checks run by Claude on 2026-10-28 against the saved `power_supplies.kicad_sch` (uncommitted): `sch-inspect` pin, power-net and label queries, and the `progress-update` preflight. Which parts share an unlabeled net was traced from wire geometry, not a netlist, because the parts are unannotated (`NOT_VERIFIED`). No datasheet values were checked. Not ERC, DRC or a human review.
- Read-only checks run by Claude on 2026-10-29 against the saved `power_supplies.kicad_sch` (uncommitted): `sch-inspect` pins and connected-pins, the `progress-update` preflight, and TI SLVSAJ0F Rev F Table 9-2 through NotebookLM (3.3 µH listed as a proven inductor value, cited). The parts are unannotated, so nets come from the sheet-local wire graph (`NOT_VERIFIED`). The TPS259251DRC values are not checked: no TPS2592x source in NotebookLM. Not ERC, DRC or a human review.
- Read-only checks run by Claude on 2026-10-31 against the saved `power_supplies.kicad_sch` (uncommitted, KiCad open): `sch-inspect` connected-pins on every part, the `progress-update` preflight, and TI data through NotebookLM source fulltext: TPS2592x SLVSCQ3B (current limit, clamp, UVLO, ramp, fault response, OUT absolute maximum; reverse blocking asked with a cited answer), TPS6214x SLVSAJ0F Rev F (pin functions, PG, soft-start), TPS735 SBVS087M (NC pins, NR and output capacitors). Nets come from the sheet-local wire graph, not a netlist (`NOT_VERIFIED`). ERC not run. Not ERC, DRC or a human review.
- Read-only checks run by Claude on 2026-11-01 against the saved files (uncommitted, KiCad open): a `kicad-cli` netlist export of the saved schematic (it reports annotation errors), the `progress-update` preflight, and TI TPS2121 data through NotebookLM source fulltext (SLVSEA3F: ratings, current limit, OV divider, soft-start, modes table, reverse blocking, ST pin). Library part checks: `sym_check` (pins against the pin table and footprint pads), `klc_verify`, the link audit and a `kicad-cli` SVG export. ERC not run. Not ERC, DRC or a human review.
- Read-only checks run by Claude on 2026-11-03 against the saved files (uncommitted, KiCad open): `progress-update` preflight, a diff of the power sheet parts against `HEAD`, and `sch-inspect` local-net and project-net on U101 to U103, Q101, D103, D104 and the power mux resistors. Nets come from the sheet-local wire graph. No datasheet was checked for Q101, D103 or D104, and no LCSC code was checked (`NOT_VERIFIED`). Not ERC, DRC or a human review.
- Read-only checks run by Claude on 2026-11-03 against the saved files (14:24 save, uncommitted, KiCad open): `sch-inspect` local-net on every power-mux resistor, Q101, D103 and D104; TI TPS212x SLVSEA3F (ST recommended range, pull-up range, leakage, VREF falling) and TI TPS735 SBVS087M (input 7 V absolute maximum, 6.5 V recommended) through NotebookLM source fulltext. OV trip and ST divider values are calculations (`ESTIMATED`). The ST low level is not specified by TI (`NOT_VERIFIED`). Not ERC, DRC or a human review.
- LCSC code check on 2026-11-03: all 13 LCSC codes on fitted parts of `power_supplies.kicad_sch` show the expected MPN and maker on their LCSC product pages (supplier listing, read through a fetch tool; C22400107 and C48935695 re-checked by hand). Not a datasheet check.
- Read-only checks run by Claude on 2026-11-11 for the skill sync (`d20d019`): the skills' synthetic tests pass (schematic 38, PCB 48), and 896 `sch-inspect` commands on the saved AO-Horizon schematic give the same output as the v3.3.0 scripts. D106 on `power_supplies.kicad_sch` is saved with a `lib_name` and now uses that symbol definition; its pin positions are unchanged. `pcb-inspect` is `NOT_VERIFIED` on this project: the saved PCB has no footprints. Not ERC, DRC or a human review.
