Natchpai/AeroOptix-Horizon/hardware/AO-Horizon/documents/AO-Horizon_2026-10-31_V1.0.pdf

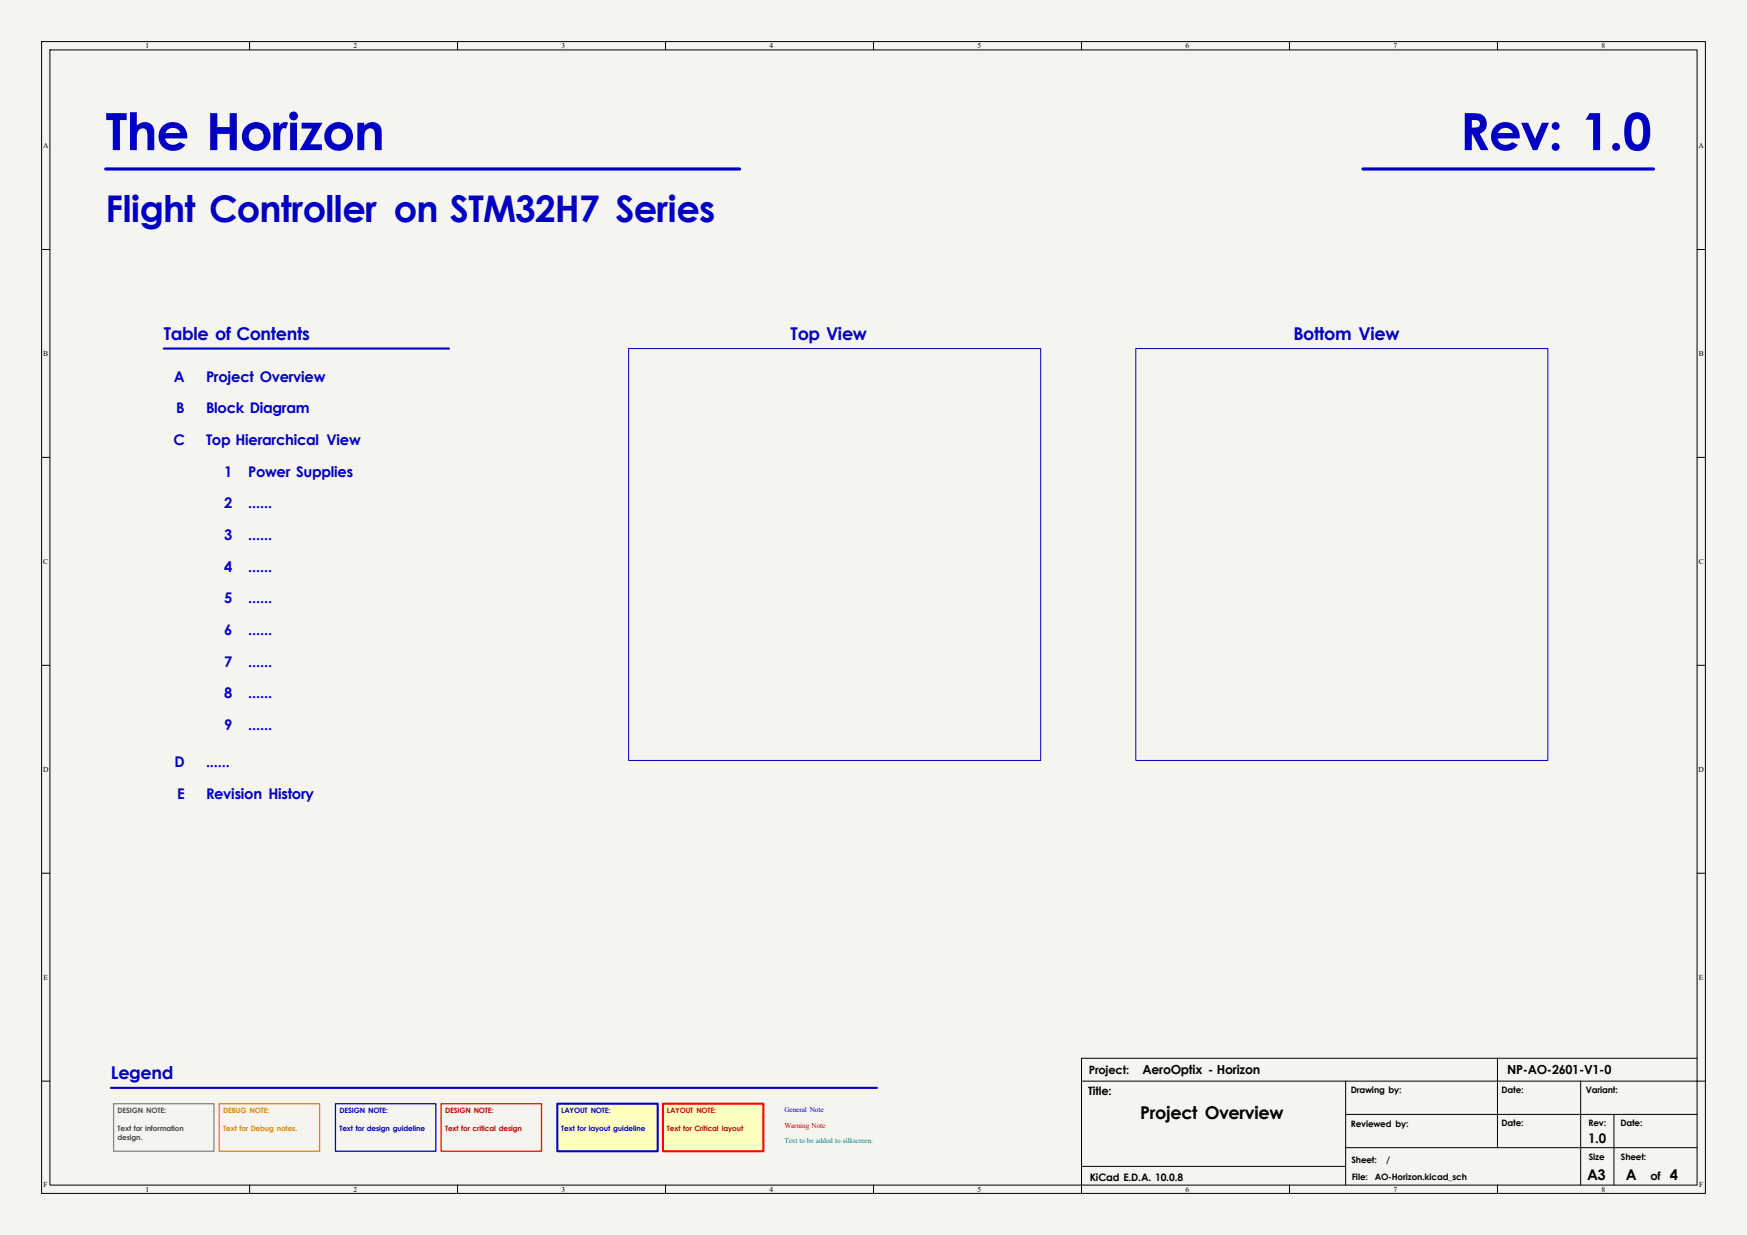
[picture p2: page 1]

Flight Controller on STM32H7 Series

LAYOUT NOTE: Text for Critical layout DESIGN NOTE: Text for critical design DESIGN NOTE: Text for design guideline DESIGN NOTE: Text for information design.

General Note Text to be added to silkscreen. Warning Note

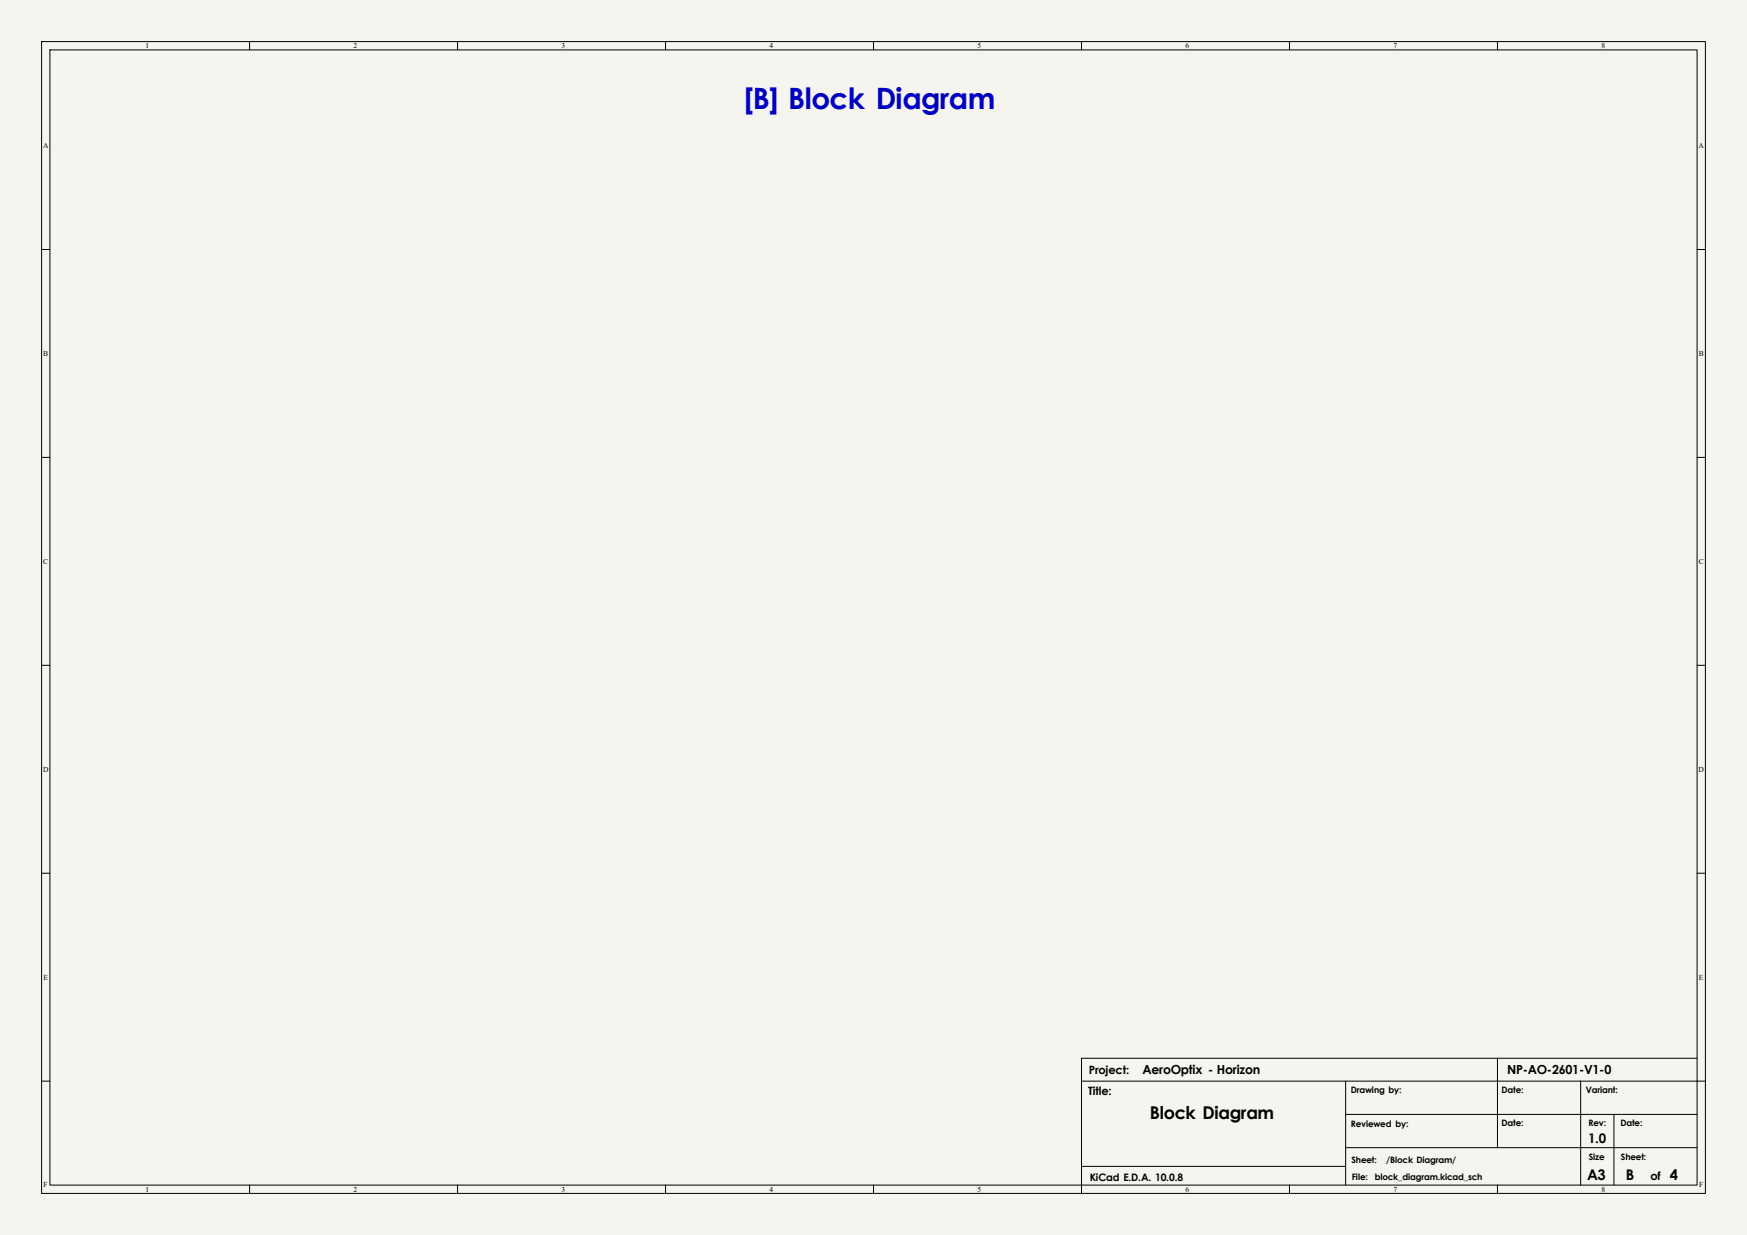
[picture p3: page 2]

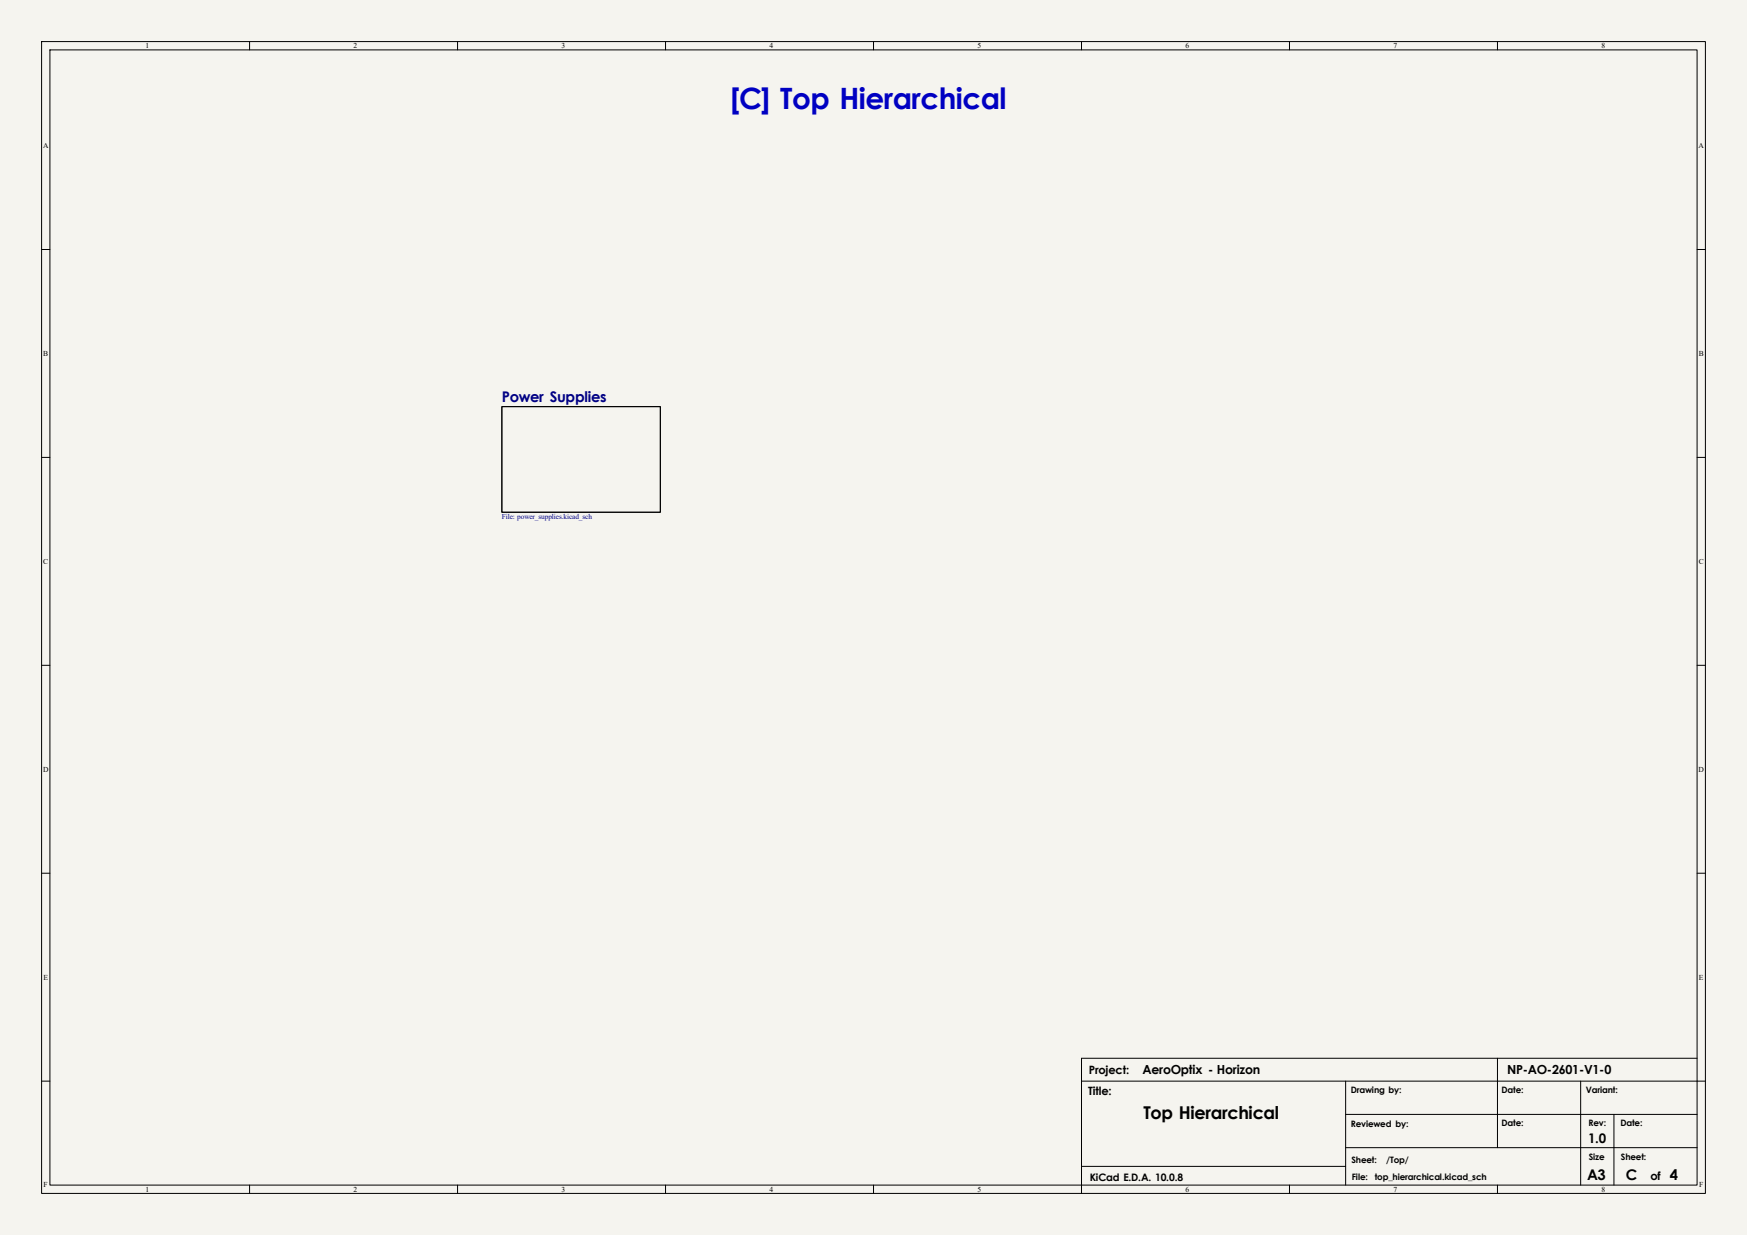
[picture p4: page 3]

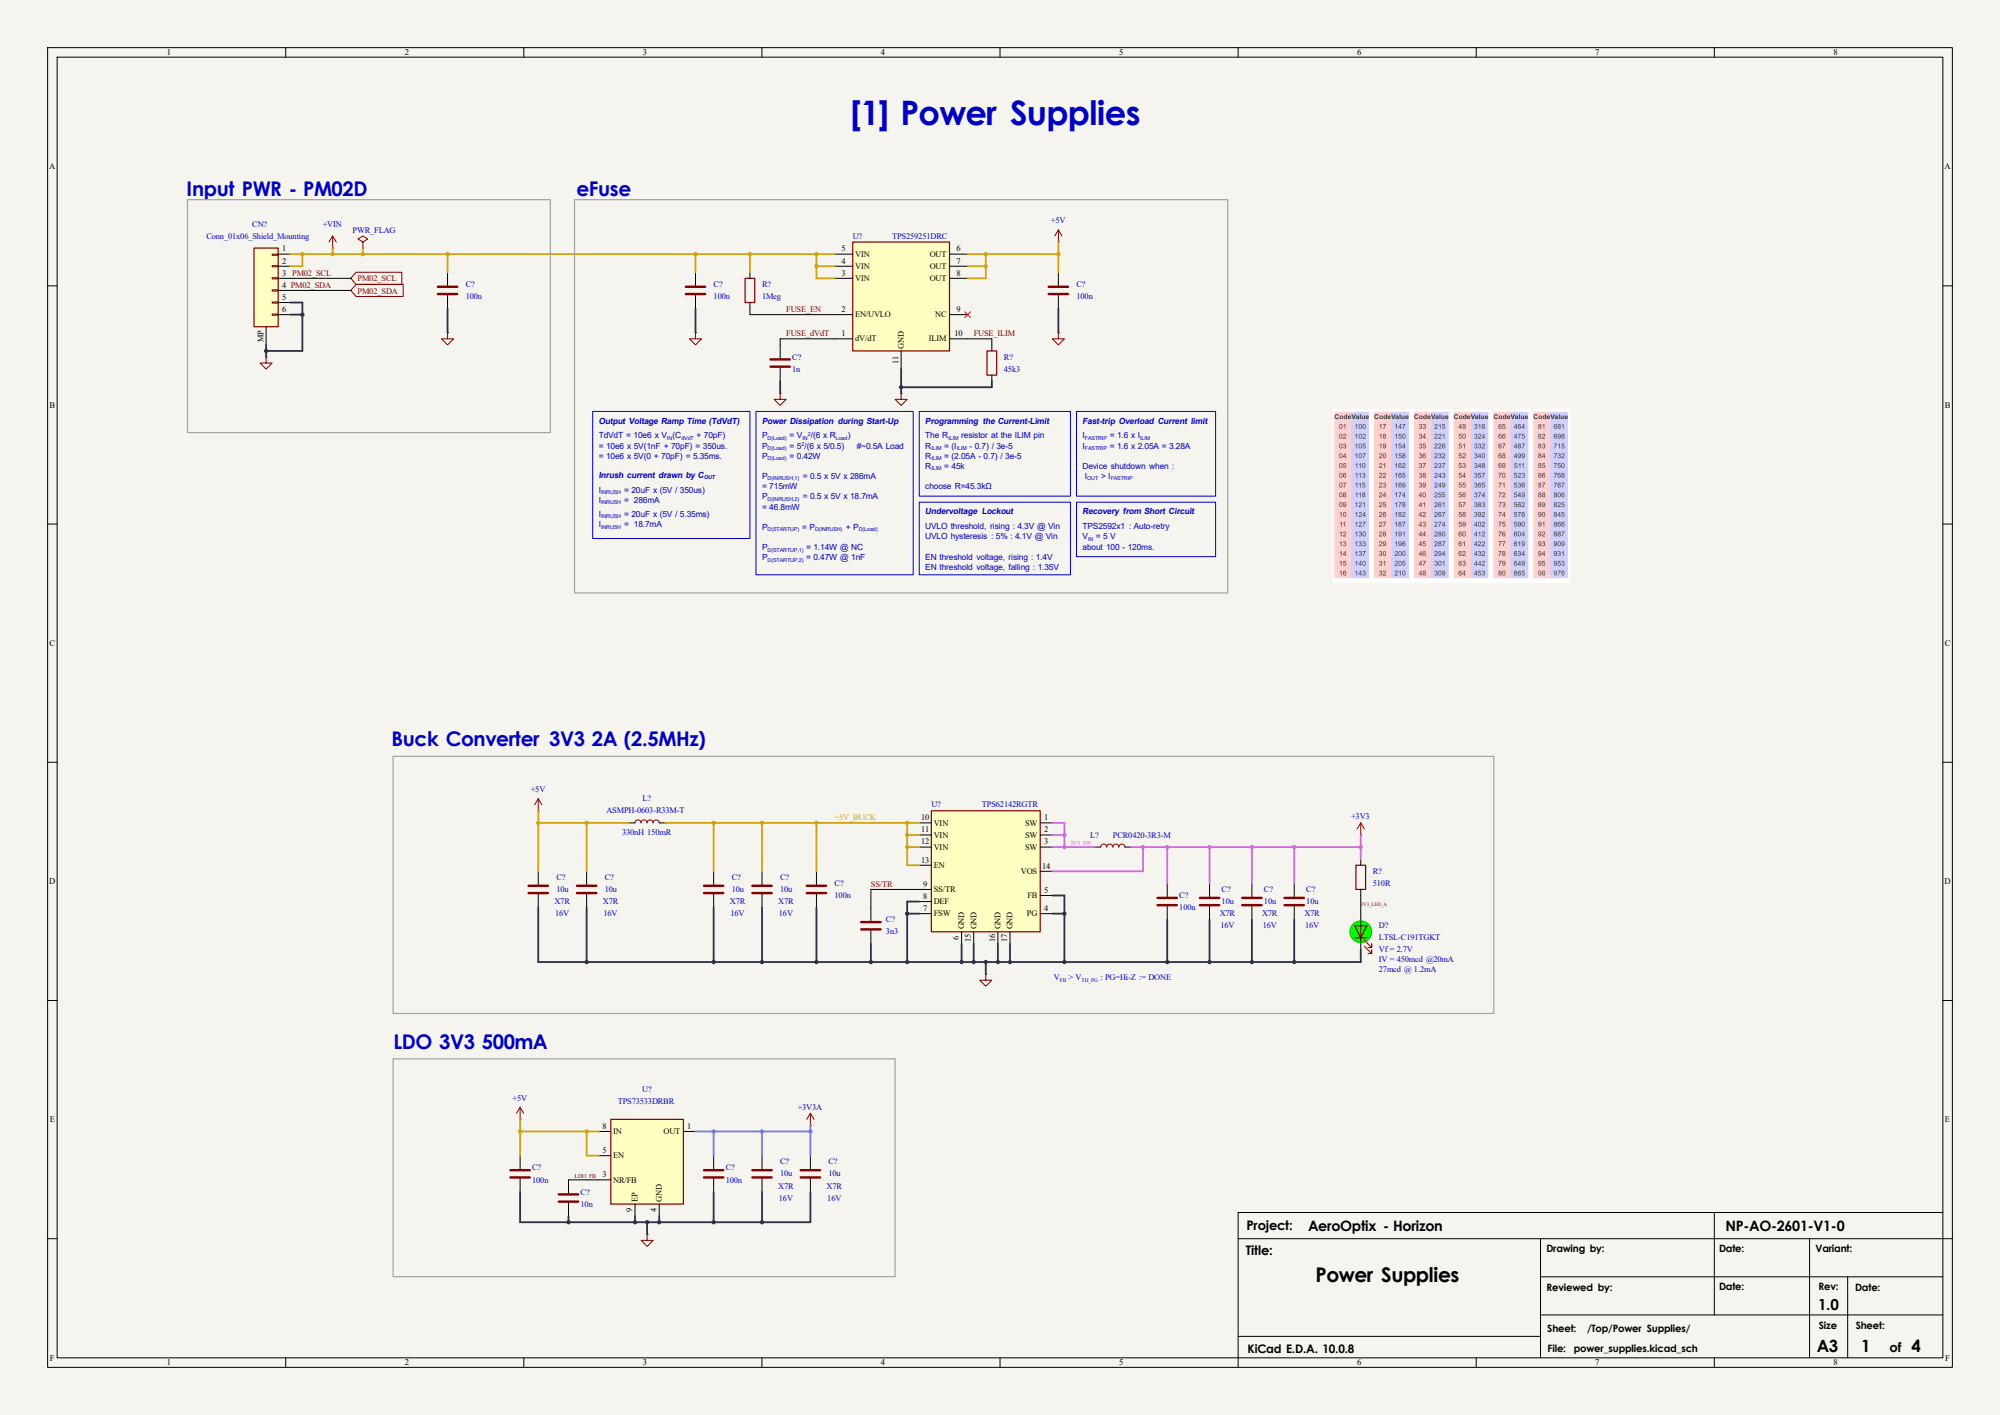
[picture p5: page 4]

IFASTRIP = 1.6 x IILIM
IFASTRIP = 1.6 x 2.05A = 3.28A Device shutdown when :

UVLO threshold, rising : 4.3V @ Vin UVLO hysteresis : 5% : 4.1V @ Vin EN threshold voltage, rising : 1.4V

PD(STARTUP) = PD(INRUSH) + PD(Load) PD(STARTUP,1) = 1.14W @ NC

6 FSW 7 DEF 8 SS/TR 9 VIN 10 VIN 11 VIN 12 EN 13 VOS 14 GND 15 GND 16 GND 17 U? TPS62142RGTR

VFB > VTH_PG : PG=Hi-Z := DONE

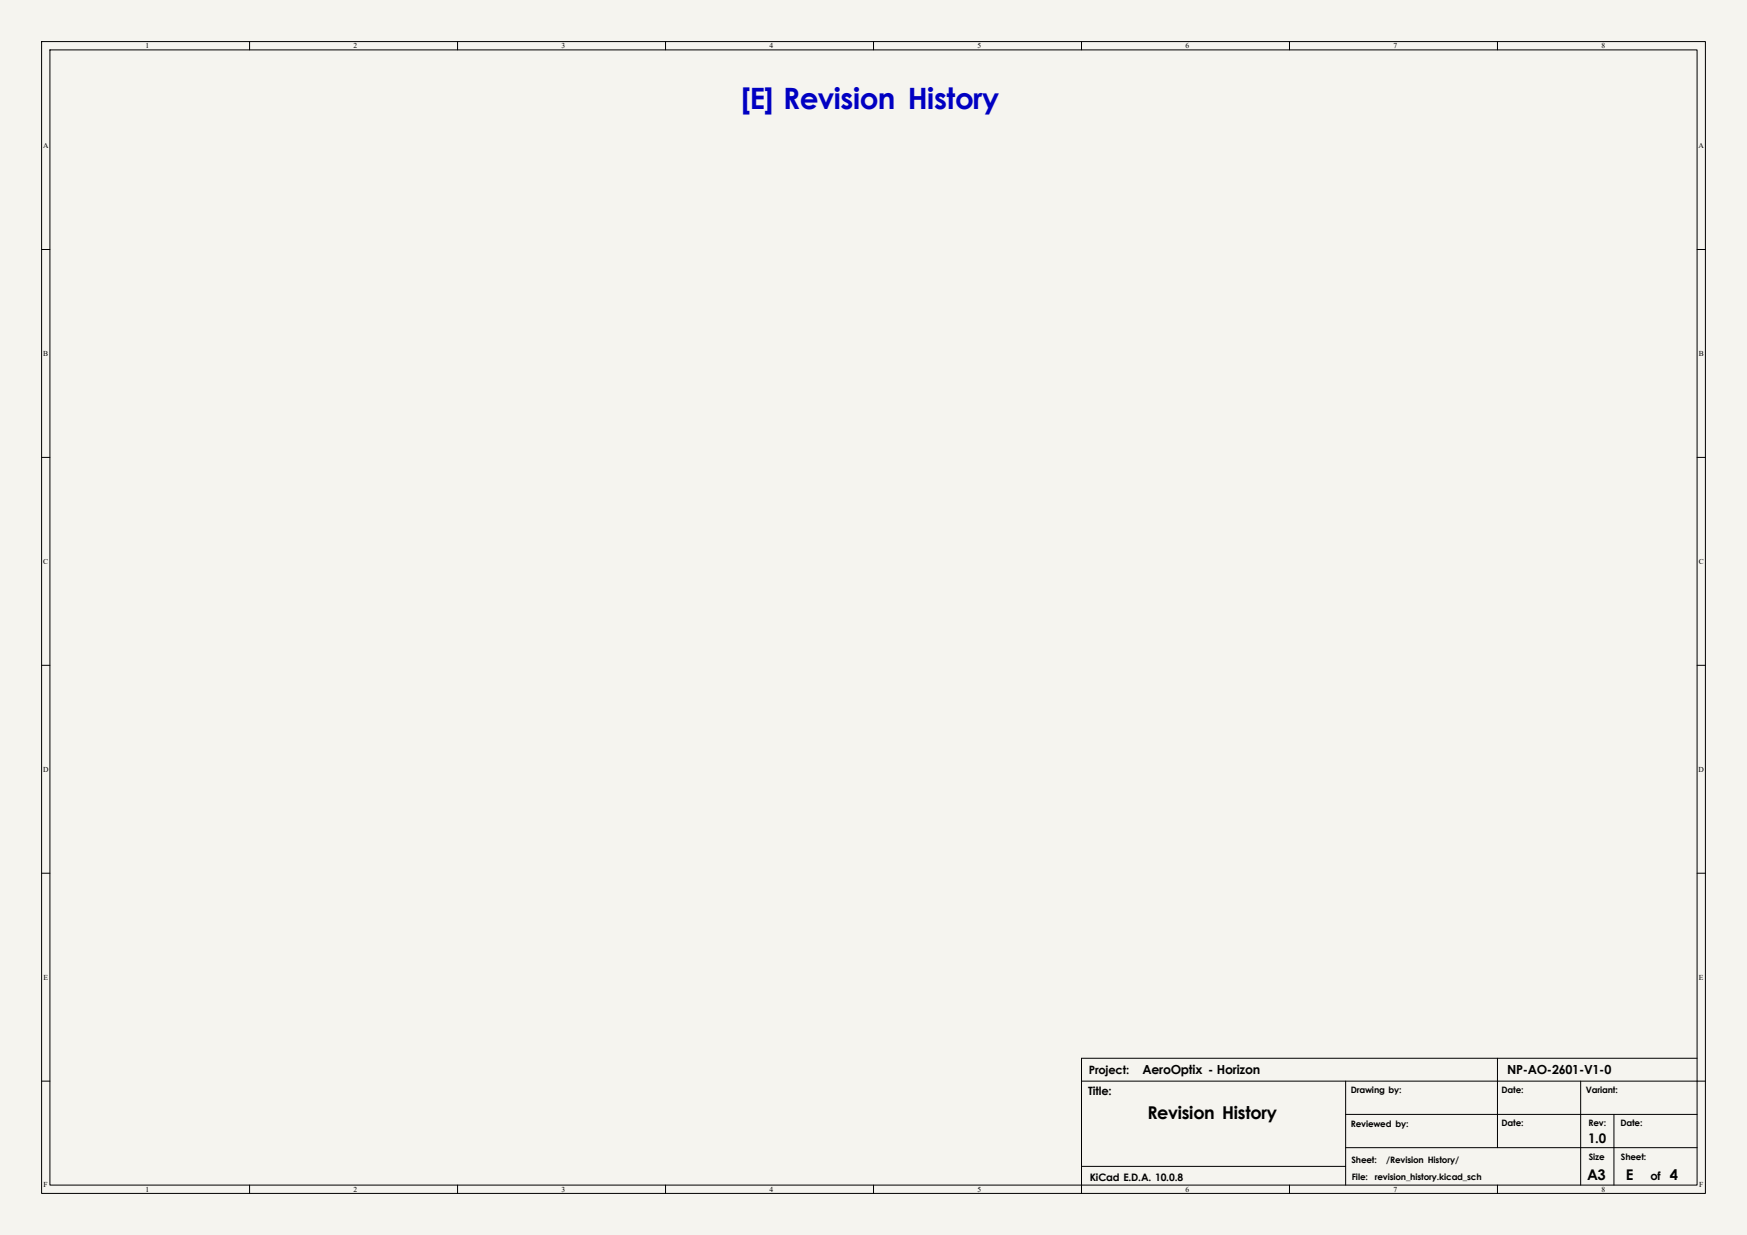
[picture p6: page 5]
