Natchpai/AeroOptix-Horizon/hardware/AO-Horizon/power_supplies.kicad_sch

## KiCad design hardware/AO-Horizon/power_supplies.kicad_sch (2026-11-03, an earlier design)

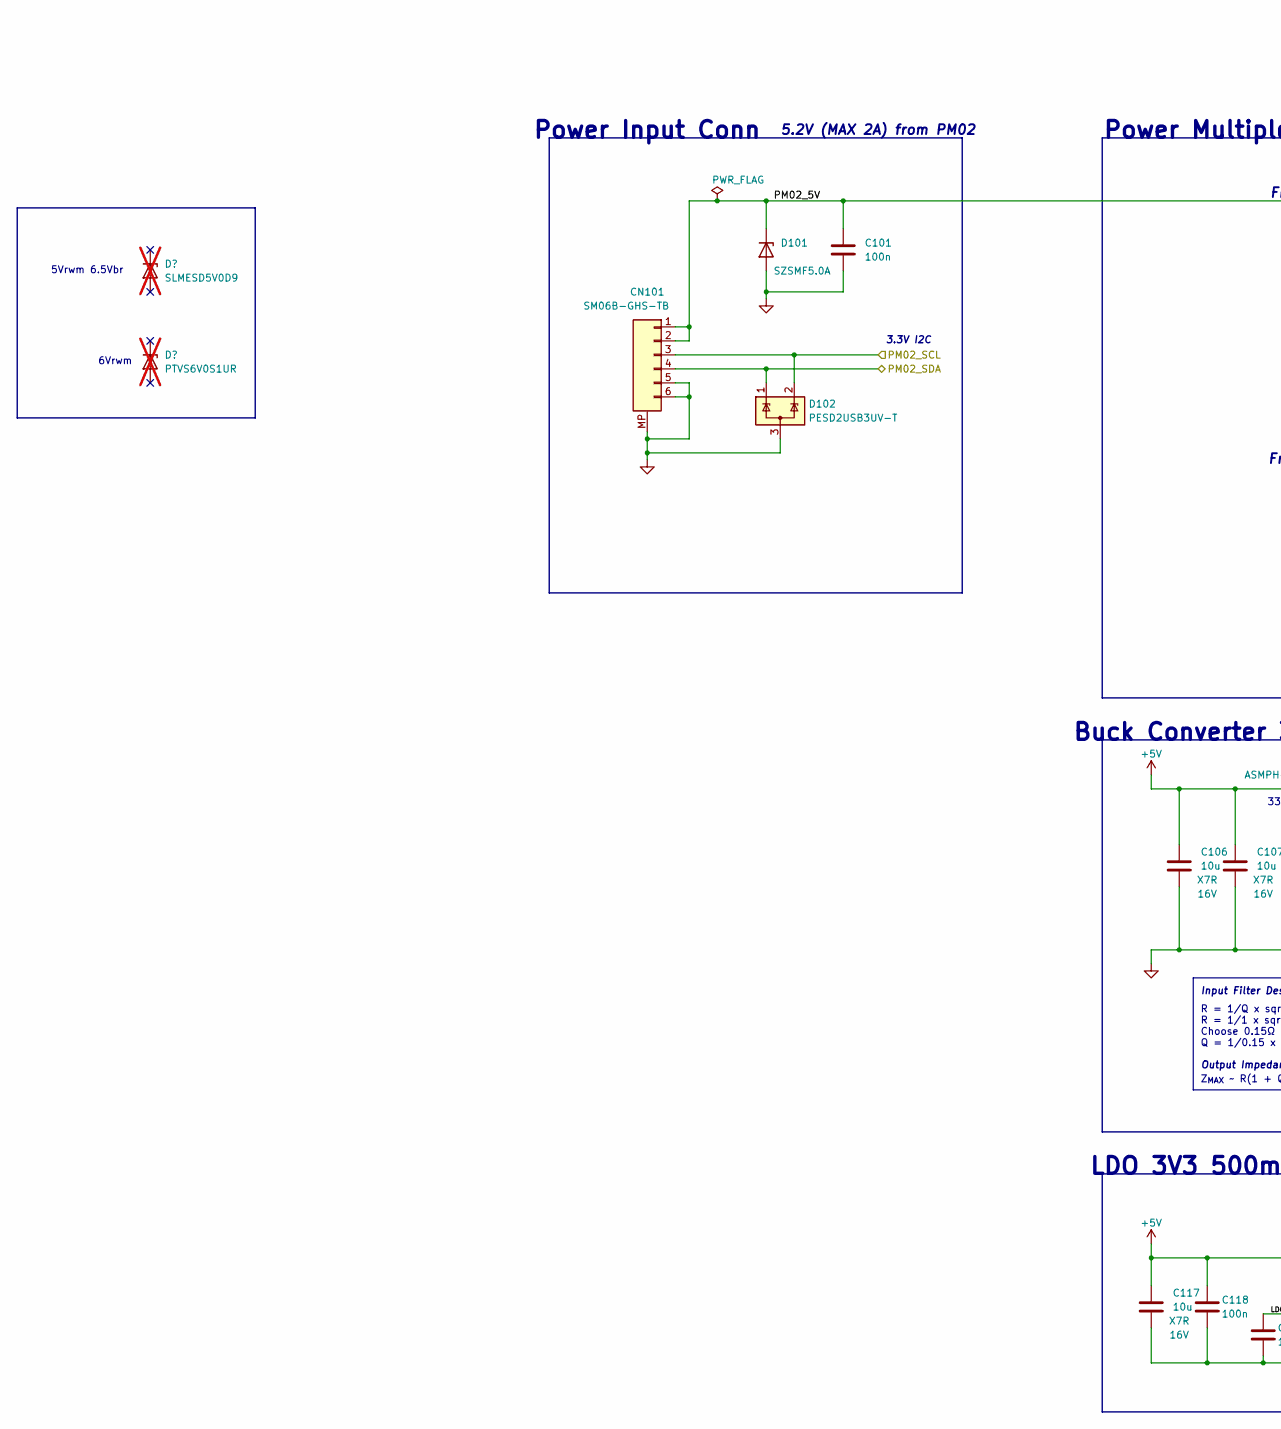
[picture p7: schematic power_supplies.kicad_sch, part in row 1, column 1]

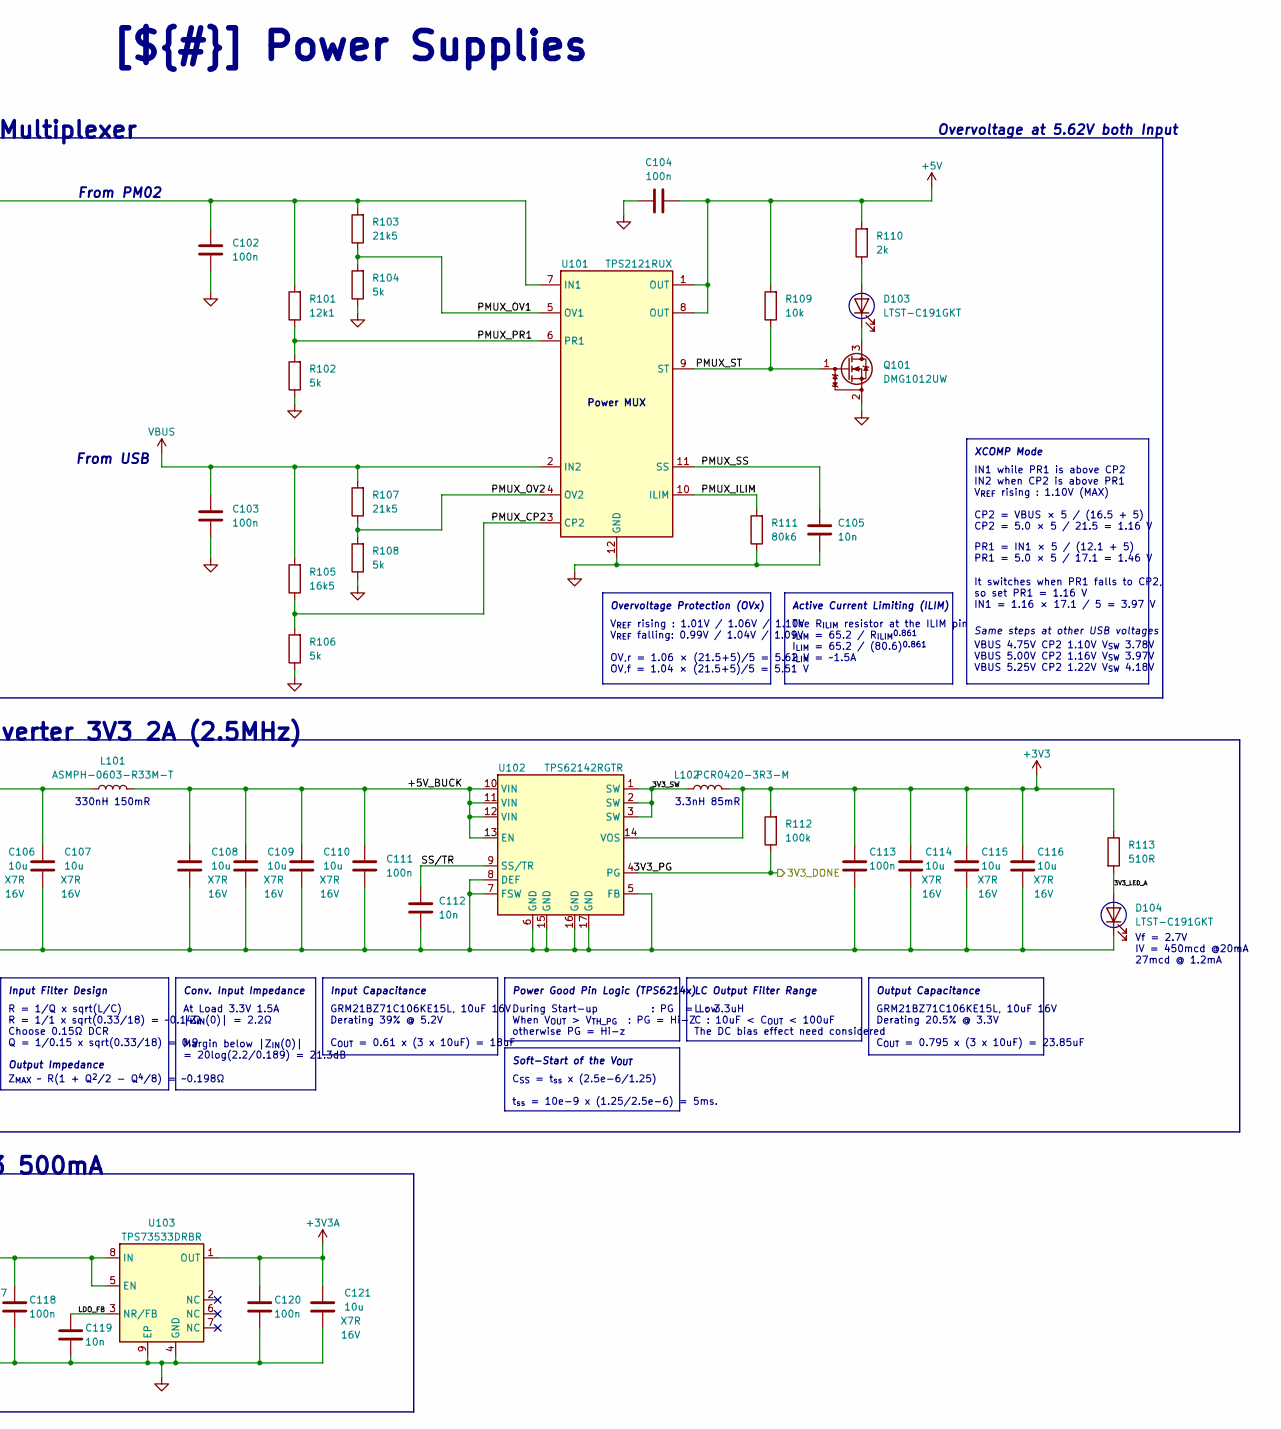
[picture p8: schematic power_supplies.kicad_sch, part in row 1, column 2]

Parts:
C101, C102, C103, C104, C111, C113, C118, C120: 100n; C_0402_1005Metric_NomDensity; MFR.P/N GCM155R71H104KE02D; LCSC C85858
C105, C112, C119: 10n; C_0402_1005Metric_NomDensity; MFR.P/N GRM1555C1H103JE01D; LCSC C22400107
C106, C107, C108, C109, C110, C114, C115, C116, C117, C121: 10u; C_0805_2012Metric_NomDensity; MFR.P/N GRM21BZ71C106KE15L; LCSC C162430
CN101: SM06B-GHS-TB; JST_GH_SM06B-GHS-TB_1x06-1MP_P1.25mm_Horizontal; MFR.P/N SM06B-GHS-TB(LF)(SN); LCSC C133065
D101: SZSMF5.0A; D_SOD-123FL; MFR.P/N SZSMF5.0AT1G; LCSC C5299833
D102: PESD2USB3UV-T; SOT-23; MFR.P/N PESD2USB3UV-TR; LCSC C3704436
D103, D104: LTST-C191GKT; LED_0603_1608Metric; MFR.P/N LITEON; LCSC C99289
L101: ASMPH-0603-R33M-T; L_0603_1608Metric; MFR.P/N ASMPH-0603-R33M-T; LCSC C7217516
L102: PCR0420-3R3-M; L_JIERR_PCR0420; MFR.P/N PCR0420-3R3-M; LCSC C53896857
Q101: DMG1012UW; SOT-323_SC-70; MFR.P/N DMG1012UW; LCSC C48935695
R101: 12k1; R_0402_1005Metric_NomDensity
R102, R104, R106, R108: 5k; R_0402_1005Metric_NomDensity
R103, R107: 21k5; R_0402_1005Metric_NomDensity
R105: 16k5; R_0402_1005Metric_NomDensity
R109: 10k; R_0402_1005Metric_NomDensity
R110: 2k; R_0402_1005Metric_NomDensity
R111: 80k6; R_0402_1005Metric_NomDensity
R112: 100k; R_0402_1005Metric_NomDensity
R113: 510R; R_0402_1005Metric_NomDensity
U101: TPS2121RUX; Texas_VQFN-HR-12_2x2.5mm_P0.5mm_ThermalVias; MFR.P/N TPS2121RUXR; LCSC C485916
U102: TPS62142RGTR; VQFN-16-1EP_3x3mm_P0.5mm_EP1.68x1.68mm_ThermalVias; MFR.P/N TPS62142RGTR; LCSC C129331
U103: TPS73533DRBR; VSON-8-1EP_3x3mm_P0.65mm_EP1.5x1.75mm_ThermalVias; MFR.P/N TPS73533DRBR; LCSC C388480

Connections:
3V3_DONE: R112.1, U102.4 (PG)
3V3_LED_A: D104.2 (A), R113.2
3V3_SW: L102.1, U102.1 (SW), U102.2 (SW), U102.3 (SW)
+3V3: C113.1, C114.1, C115.1, C116.1, L102.2, R112.2, R113.1, U102.14 (VOS)
+3V3A: C120.1, C121.1, U103.1 (OUT)
+5V: C104.1, C106.1, C107.1, C117.1, C118.1, L101.1, R109.2, R110.2, U101.1 (OUT), U101.8 (OUT), U103.5 (EN), U103.8 (IN)
+5V_BUCK: C108.1, C109.1, C110.1, C111.1, L101.2, U102.10 (VIN), U102.11 (VIN), U102.12 (VIN), U102.13 (EN)
GND: C101.2, C102.2, C103.2, C104.2, C105.2, C106.2, C107.2, C108.2, C109.2, C110.2, C111.2, C112.2, C113.2, C114.2, C115.2, C116.2, C117.2, C118.2, C119.2, C120.2, C121.2, CN101.5, CN101.6, CN101.MP (MountPin), D101.2 (A), D102.3 (A), D104.1 (K), Q101.2 (S), R102.1, R104.1, R106.1, R108.1, R111.1, U101.12 (GND), U102.5 (FB), U102.6 (GND), U102.7 (FSW), U102.8 (DEF), U102.15 (GND), U102.16 (GND), U102.17 (GND), U103.4 (GND), U103.9 (EP)
LDO_FB: C119.1, U103.3 (NR/FB)
unnamed: D103.1 (K), Q101.3 (D)
unnamed: D103.2 (A), R110.1
PM02_5V: C101.1, C102.1, CN101.1, CN101.2, D101.1 (K), R101.2, R103.2, U101.7 (IN1)
PM02_SCL: CN101.3, D102.2 (K)
PM02_SDA: CN101.4, D102.1 (K)
PMUX_CP2: R105.1, R106.2, U101.3 (CP2)
PMUX_ILIM: R111.2, U101.10 (ILIM)
PMUX_OV1: R103.1, R104.2, U101.5 (OV1)
PMUX_OV2: R107.1, R108.2, U101.4 (OV2)
PMUX_PR1: R101.1, R102.2, U101.6 (PR1)
PMUX_SS: C105.1, U101.11 (SS)
PMUX_ST: Q101.1 (G), R109.1, U101.9 (ST)
SS/TR: C112.1, U102.9 (SS/TR)
VBUS: C103.1, R105.2, R107.2, U101.2 (IN2)

Notes on the sheet:
Margin below |Z_{IN}(0)| = 20log(2.2/0.189) = 21.3dB
330nH 150mR
Soft-Start of the V_{OUT}
V_{REF} rising : 1.01V / 1.06V / 1.10V V_{REF} falling: 0.99V / 1.04V / 1.09V OV,r = 1.06 × (21.5+5)/5 = 5.62 V OV,f = 1.04 × (21.5+5)/5 = 5.51 V
IN1 while PR1 is above CP2 IN2 when CP2 is above PR1 V_{REF} rising : 1.10V (MAX) CP2 = VBUS × 5 / (16.5 + 5) CP2 = 5.0 × 5 / 21.5 = 1.16 V
From PM02
3.3nH 85mR
Conv. Input Impedance
Input Filter Design
Power Good Pin Logic (TPS6214x)
L : 3.3uH C : 10uF < C_{OUT} < 100uF The DC bias effect need considered
3.3V I2C
Input Capacitance
Output Impedance
During Start-up : PG = Low When V_{OUT} > V_{TH_PG} : PG = Hi-Z otherwise PG = Hi-z
C_{SS} = t_{ss} x (2.5e-6/1.25) t_{ss} = 10e-9 x (1.25/2.5e-6) = 5ms.
GRM21BZ71C106KE15L, 10uF 16V Derating 39% @ 5.2V C_{OUT} = 0.61 x (3 x 10uF) = 18uF
Vf = 2.7V IV = 450mcd @20mA 27mcd @ 1.2mA
Same steps at other USB voltages
LDO 3V3 500mA
XCOMP Mode
Power Input Conn
It switches when PR1 falls to CP2, so set PR1 = 1.16 V IN1 = 1.16 × 17.1 / 5 = 3.97 V
The R_{ILIM} resistor at the ILIM pin I_{LIM} = 65.2 / R_{ILIM}^{0.861} I_{LIM} = 65.2 / (80.6)^{0.861} I_{LIM} = ~1.5A
Overvoltage Protection (OVx)
LC Output Filter Range
6Vrwm
Power Multiplexer
Power MUX
From USB
Overvoltage at 5.62V both Input
Output Capacitance
VBUS 4.75V CP2 1.10V V_{SW} 3.78V VBUS 5.00V CP2 1.16V V_{SW} 3.97V VBUS 5.25V CP2 1.22V V_{SW} 4.18V
Z_{MAX} ~ R(1 + Q^{2}/2 - Q^{4}/8) = ~0.198Ω
[${#}] ${COMMENT1}
PR1 = IN1 × 5 / (12.1 + 5) PR1 = 5.0 × 5 / 17.1 = 1.46 V
5Vrwm 6.5Vbr
5.2V (MAX 2A) from PM02
At Load 3.3V 1.5A |Z_{IN}(0)| = 2.2Ω
R = 1/Q x sqrt(L/C) R = 1/1 x sqrt(0.33/18) = ~0.14Ω Choose 0.15Ω DCR Q = 1/0.15 x sqrt(0.33/18) = 0.9
Active Current Limiting (ILIM)
Buck Converter 3V3 2A (2.5MHz)
GRM21BZ71C106KE15L, 10uF 16V Derating 20.5% @ 3.3V C_{OUT} = 0.795 x (3 x 10uF) = 23.85uF
