Natchpai/AeroOptix-Horizon/hardware/AO-Horizon/sensor-barometer.kicad_sch

## KiCad design hardware/AO-Horizon/sensor-barometer.kicad_sch (2026-11-12)

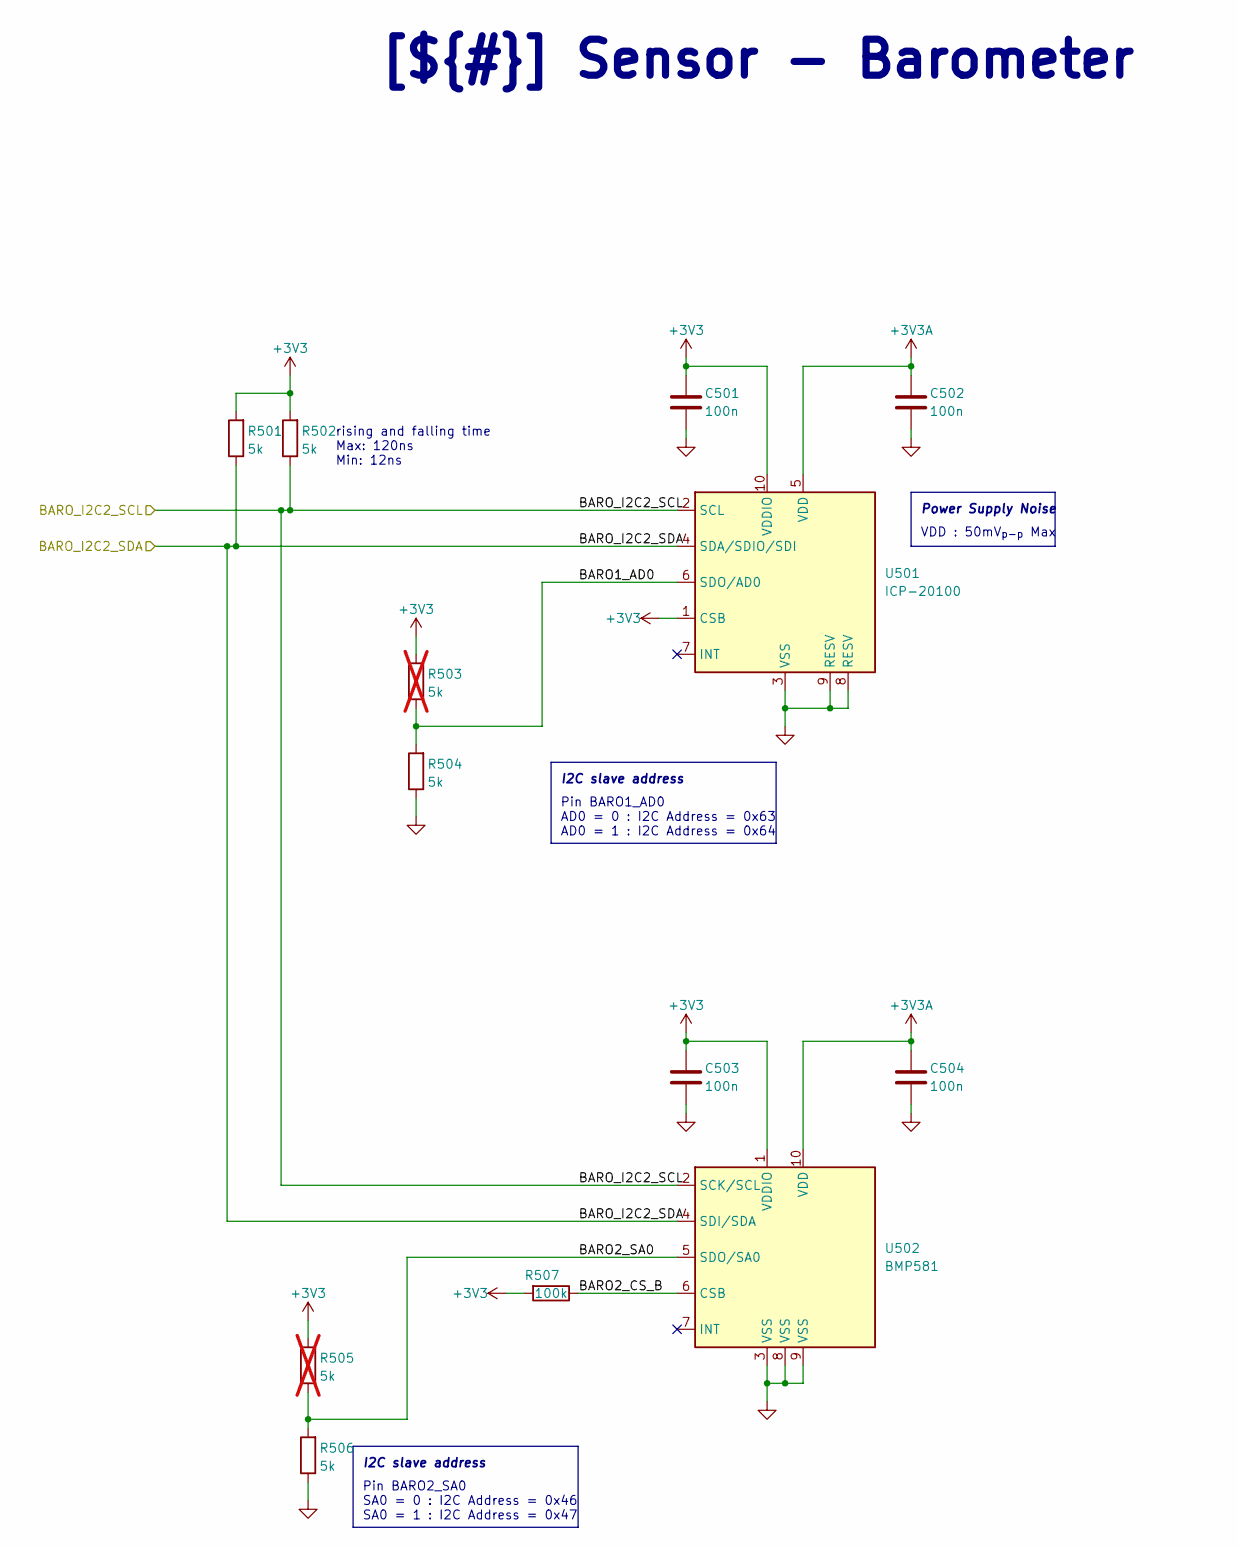
[picture p9: schematic sensor-barometer.kicad_sch]

Parts:
C501, C502, C503, C504: 100n; C_0402_1005Metric_NomDensity; MFR.P/N GCM155R71H104KE02D; LCSC C85858
R501, R502, R504, R506: 5k; R_0402_1005Metric_NomDensity
R503, R505: 5k; R_0402_1005Metric_NomDensity; not fitted
R507: 100k; R_0402_1005Metric_NomDensity
U501: ICP-20100; ST_HLGA-10_2x2mm_P0.5mm_LayoutBorder3x2y; MFR.P/N ICP-20100; LCSC C5343527
U502: BMP581; Bosch_LGA-10_2x2mm_P0.5mm_LayoutBorder3x2y; MFR.P/N BMP581; LCSC C5362283

Connections:
+3V3: C501.1, C503.1, R501.2, R502.2, R503.2, R505.2, R507.2, U501.1 (CSB), U501.10 (VDDIO), U502.1 (VDDIO)
+3V3A: C502.1, C504.1, U501.5 (VDD), U502.10 (VDD)
BARO1_AD0: R503.1, R504.2, U501.6 (SDO/AD0)
BARO2_CS_B: R507.1, U502.6 (CSB)
BARO2_SA0: R505.1, R506.2, U502.5 (SDO/SA0)
BARO_I2C2_SCL: R502.1, U501.2 (SCL), U502.2 (SCK/SCL)
BARO_I2C2_SDA: R501.1, U501.4 (SDA/SDIO/SDI), U502.4 (SDI/SDA)
GND: C501.2, C502.2, C503.2, C504.2, R504.1, R506.1, U501.3 (VSS), U501.8 (RESV), U501.9 (RESV), U502.3 (VSS), U502.8 (VSS), U502.9 (VSS)

Notes on the sheet:
Power Supply Noise
VDD : 50mV_{p-p} Max
[${#}] ${COMMENT1}
I2C slave address
rising and falling time Max: 120ns Min: 12ns
Pin BARO1_AD0 AD0 = 0 : I2C Address = 0x63 AD0 = 1 : I2C Address = 0x64
Pin BARO2_SA0 SA0 = 0 : I2C Address = 0x46 SA0 = 1 : I2C Address = 0x47
