Natchpai/AeroOptix-Horizon/(commit log)

2026-10-08 Initial project
    [AO-Horizon.kicad_pcb, AO-Horizon.kicad_sch]
2026-10-10 Delect bank kicad files
    [AO-Horizon.kicad_pcb, AO-Horizon.kicad_sch]
2026-10-10 feat: init kicad files
    [AO-Horizon.kicad_pcb, AO-Horizon.kicad_sch]
2026-10-12 docs(license): switch to CERN-OHL-S-2.0 and sync dev (#1)
    * Add draft specifications
    * fix(claude): rename misspelled .cluade config folder to .claude
    Rules, skills, the KiCad protection hook and permissions were not
    loaded because Claude Code only reads .claude/.
    * docs: update CLAUDE.md and README, add initial CHANGELOG
    Document repo layout and working rules in CLAUDE.md, add spec-backed
    overview and documentation links to README, and start the changelog.
    * change: Library to low case
    * Update README.md
    * Update CLAUDE.md
    * Update README.md
    * Update settings.local.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
2026-10-18 docs(design): add sensor, power and pin allocation records (#3)
    * docs(readme): simplify workflow diagram explanation
    Mark DRAFT as under review, sync CHECK label, and add a colour key in README and template.
    * Update settings.json
    * change spec file name
    * update git-workflow skill
    * change skill name by add hw-*
    * docs: update AeroOptix-Horizon hardware spec
    * docs: consolidate hardware handoff into checklist
    * feat(hooks): replace protect hook with rule-based v2
    Move file-protection rules into hooks/protect.json (allow > deny > ask)
    and use ask for editable-with-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
2026-10-18 chore(claude): track project skills (#5)
    and use ask for editable-with-approval files instead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
2026-10-18 feat(power): add TPS62142 3V3 buck and new library parts (#6)
    and use ask for editable-with-ap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
2026-10-19 feat(library): add sensor starting points and sync design docs (#8)
    and use ask for editable-w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
2026-10-23 feat: switch magnetometer to IST8310, add eFuse and draft pins (#13)
    and use ask for editable-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
2026-10-24 docs(design): F100 switch, integration answers and hardware decisions (spec 0.14) (#17)
    and us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
2026-10-24 feat(web): rail colours, SVG export, record-driven Overview, IO MCU layout (#20)
    and use ask f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
2026-10-24 fix(web): lighter +6V rail colour in the light theme (#21)
    and use ask for editable-with-appro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
2026-10-24 feat(web): thicker diagram lines, pink 3.3V, browser tests, team logo (#23)
    and use ask for ed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
2026-10-24 feat(web): GPIO back to pink, +3.3V rail fuchsia, new README title (#24)
    and use ask for edita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
2026-10-26 feat: DEC-025 records, Power view and diagram zones (#27)
    and use ask for editable-with-approv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
2026-10-28 docs: power sheet state in spec 0.17, status report and v2 logo (#28)
    and use ask for editable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
2026-10-28 feat(schematic): power sheet with wired eFuse, cleared block diagram, report PDF (#29)
    and use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
2026-10-29 feat: TPS259251DRC eFuse (DEC-026), spec 0.18 and power view update (#30)
    and use ask for edit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
2026-10-31 feat: close the power sheet capture (spec 0.19, DEC-027, DEC-028) (#31)
    and use ask for editab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
2026-11-01 feat: TPS2121 power mux with PM02D priority (spec 0.20 to 0.23) (#32)
    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
2026-11-03 feat: power mux status LED and rev A title blocks (spec 0.24) (#33)
    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
2026-11-03 feat: power sheet close-out, input capacitors and LDO enable from PG (spec 0.30) (#34)
    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
2026-11-03 feat: PM02D CLIK-Mate connector, 5 V budget and README cleanup (spec 0.31 to 0.33) (#35)
    and u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
2026-11-12 feat: MCU and sensor sheets, DEC-043 sensor rail (spec 0.34) (#36)
    and use ask for editable-with-approval files instead of a hard block.
    Bash/PowerShell checks now inspect write targets, not any mention of a
    protected path. Align settings.json permissions and drop the old hook.
    * docs: update CLAUDE.md for protection tiers and skill names
    Describe the ask/deny protection rules, the v2 hook and protect.json,
    and fix stale skill and template names.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
